lumunoz12/preprosthetic-robotic-hand/data/Test_Hand.xlsx

Sheet: Objects
ID | Grasp | Object | Mass (g) | Dimensions (mm) | Stiffness
PIN-1 | Pinch | Phone box | 16 | 80x67x19 | D
PIN-2 | Pinch | PCB | 10 | 72x44x1,6 | R
PIN-3 | Pinch | USB drive | 18 | 60x15,6x9 | R
LAT-1 | Lateral pinch | Phone charger | 27 | 48x35x14 | D
LAT-2 | Lateral pinch | PCB | 10 | 72x44x1,6 | R
LAT-3 | Lateral pinch | Phone box | 16 | 80x67x19 | D
CIL-1 | Cylindrical | Deodorant container | 61 | 25x141 | R
CIL-2 | Cylindrical | Plastic bottle | 122 | 38x227 | R
CIL-3 | Cylindrical | Aluminum bottle | 132 | 36,5x250 | R

Sheet: Test_Lateral
Intento | Objeto | Éxito (1)/Fracaso(0) | FSR indice max (ADC) | FSR pulgar max (ADC) | Ang. final MCP indice (°) | Ang. final PIP indice (°) | Ang. final ABD pulgar (°) | Ang. final MCP pulgar (°)
1 | LAT-1 | 1 | - | 38 | 73.8 | 44.5 | 17.2 | 64.2
2 | LAT-1 | 1 | - | 76 | 73.8 | 44.6 | 17.1 | 64.1
3 | LAT-1 | 1 | - | 45 | 74 | 44.7 | 17.2 | 64.5
4 | LAT-1 | 1 | - | 308 | 73.9 | 44.6 | 17.3 | 65.6
5 | LAT-1 | 1 | - | 122 | 74 | 47.4 | 20.6 | 64.8
1 | LAT-2 | 1 | - | 48 | 73.8 | 44.6 | 17.3 | 68.5
2 | LAT-2 | 1 | - | 37 | 73.8 | 47.4 | 20.5 | 67.7
3 | LAT-2 | 1 | - | 36 | 73.7 | 44.5 | 16.9 | 68.3
4 | LAT-2 | 1 | - | 37 | 74.2 | 46.1 | 20.4 | 68.3
5 | LAT-2 | 1 | - | 40 | 73.9 | 44.7 | 17.2 | 67.8
1 | LAT-3 | 1 | - | 41 | 74 | 47.5 | 20.8 | 63.9
2 | LAT-3 | 1 | - | 39 | 73.9 | 44.6 | 17.1 | 64
3 | LAT-3 | 1 | - | 41 | 74.5 | 46.6 | 20.4 | 64.2
4 | LAT-3 | 1 | - | 479 | 73.9 | 44.7 | 17.3 | 63.9
5 | LAT-3 | 1 | - | 347 | 73.7 | 44.4 | 17.3 | 63.9

Sheet: Test_Pinch
Intento | Objeto | Éxito (1)/Fracaso(0) | FSR indice max (ADC) | FSR pulgar max (ADC) | Ang. final MCP indice (°) | Ang. final PIP indice (°) | Ang. final ABD pulgar (°) | Ang. final MCP pulgar (°) | Observaciones
1 | PIN-1 | 1 | 58 | 47 | 81.2 | 68.6 | 71.6 | 53.6
2 | PIN-1 | 1 | 138 | 47 | 80.7 | 68.7 | 71.6 | 53.6
3 | PIN-1 | 1 | 298 | 43 | 86.4 | 68.8 | 72.1 | 53.7
4 | PIN-1 | 1 | 623 | 50 | 79.6 | 68.8 | 71 | 53.8
5 | PIN-1 | 1 | 227 | 52 | 86.9 | 65.5 | 70 | 53.8
1 | PIN-2 | 1 | 54 | 45 | 83.8 | 58 | 69.9 | 53.8
2 | PIN-2 | 0 | 0 | 0 | 83.8 | 62.5 | 69.9 | 53.7
3 | PIN-2 | 0 | 0 | 0 | 84 | 62.8 | 69.9 | 53.8
4 | PIN-2 | 0 | 0 | 0 | 84.1 | 62.7 | 69.9 | 52.8
5 | PIN-2 | 0 | 0 | 0 | 84 | 63.2 | 69.8 | 53.7
1 | PIN-3 | 1 | 58 | 58 | 83.9 | 68.9 | 71.6 | 53.6
2 | PIN-3 | 0 | 0 | 0 | 83.7 | 62.6 | 69.9 | 53.7 | Error en PIP indice
3 | PIN-3 | 1 | 42 | 59 | 83.6 | 68.4 | 71.7 | 53.8
4 | PIN-3 | 1 | 48 | 54 | 83.6 | 68.6 | 72 | 53.7
5 | PIN-3 | 0 | 0 | 0 | 83.9 | 64.4 | 70.4 | 53.7

Sheet: Test_Cylindrical
Intento | Objeto | Éxito (1)/Fracaso(0) | FSR indice max (ADC) | FSR pulgar max (ADC) | Ang. final MCP indice (°) | Ang. final PIP indice (°) | Ang. final ABD pulgar (°) | Ang. final MCP pulgar (°) | Ang. final MCP medio (°) | Ang. final PIP medio (°) | Ang. final MCP anular (°) | Ang. final PIP anular (°) | Ang. final MCP meñique (°) | Ang. final PIP meñique (°)
1 | CIL-1 | 0 | 30 | 38 | 71.7 | 69.6 | 78.7 | 58.7 | 73.5 | 69.1 | 74.6 | 69.6 | 73.5 | 68.7
2 | CIL-1 | 0 | 35 | 36 | 72.8 | 70 | 78.5 | 58.4 | 77.6 | 69.2 | 78.2 | 73.6 | 77.6 | 68.7
3 | CIL-1 | 0 | 40 | 37 | 73.9 | 69.8 | 78.7 | 58.6 | 78.2 | 69.3 | 78.7 | 72.6 | 78.1 | 68.7
4 | CIL-1 | 0 | 38 | 35 | 71.9 | 69.4 | 78.7 | 58.5 | 73.3 | 68.9 | 74.2 | 69.8 | 73.4 | 68.8
5 | CIL-1 | 0 | 37 | 39 | 73.5 | 69.8 | 78.6 | 58.6 | 77.2 | 69.2 | 77.8 | 73 | 77.2 | 68.8
1 | CIL-2 | 1 | 30 | 30 | 62.5 | 55.1 | 78.4 | 43.5 | 63.7 | 54 | 64.9 | 55.2 | 63.9 | 54.3
2 | CIL-2 | 1 | 35 | 36 | 62.5 | 55.2 | 78.4 | 43.6 | 63.9 | 54.4 | 65 | 55.2 | 64 | 54.4
3 | CIL-2 | 0 | 38 | 43 | 62.6 | 54.9 | 78.5 | 43.6 | 63.7 | 54.5 | 65.2 | 0 | 63.6 | 54.2
4 | CIL-2 | 0 | 33 | 34 | 62.6 | 55.1 | 78.7 | 43.5 | 68 | 54.2 | 67.5 | 57.7 | 68 | 54.7
5 | CIL-2 | 1 | 37 | 37 | 64.3 | 56.4 | 78.7 | 43.6 | 68 | 55.3 | 68.6 | 58.1 | 68 | 56.2
1 | CIL-3 | 0 | 40 | 44 | 65.5 | 60.9 | 78.8 | 48.6 | 69.5 | 59.3 | 68.6 | 63.9 | 69.5 | 60.3
2 | CIL-3 | 0 | 43 | 39 | 62.6 | 60.2 | 78.7 | 48.6 | 64.6 | 59.2 | 66.4 | 59.5 | 65.1 | 59
3 | CIL-3 | 0 | 33 | 38 | 63.3 | 59.7 | 78.6 | 48.6 | 64.6 | 59.3 | 66.5 | 59.4 | 65.2 | 58.9
4 | CIL-3 | 0 | 30 | 33 | 65 | 61 | 78.6 | 48.6 | 68.9 | 59.3 | 69.7 | 62.3 | 69 | 59.6
5 | CIL-3 | 0 | 39 | 51 | 62.4 | 61.2 | 78.6 | 48.7 | 68.6 | 59.3 | 69.1 | 63.6 | 68.7 | 59.6

Sheet: Stats
Statistics per object (n = 5 attempts, including failures). Mean and sample standard deviation (STDEV). Paper Tables IV and V.
Object | Successes | Index FSR mean (ADC) | Index FSR SD (ADC) | Thumb FSR mean (ADC) | Thumb FSR SD (ADC) | Index MCP mean (°) | Index MCP SD (°) | Index PIP mean (°) | Index PIP SD (°) | Thumb ABD mean (°) | Thumb ABD SD (°) | Thumb MCP mean (°) | Thumb MCP SD (°)
PIN-1 | 5 | 268.8 | 217.7 | 47.8 | 3.4 | 83.0 | 3.4 | 68.1 | 1.4 | 71.3 | 0.8 | 53.7 | 0.1
PIN-2 | 1 | 10.8 | 24.1 | 9.0 | 20.1 | 83.9 | 0.1 | 61.8 | 2.2 | 69.9 | 0.04472135955 | 53.6 | 0.4
PIN-3 | 3 | 29.6 | 27.6 | 34.2 | 31.3 | 83.7 | 0.2 | 66.6 | 2.9 | 71.1 | 0.9 | 53.7 | 0.1
Pinch total | 9
LAT-1 | 5 | – | – | 117.8 | 111.4 | 73.9 | 0.1 | 45.2 | 1.3 | 17.9 | 1.5 | 64.6 | 0.6
LAT-2 | 5 | – | – | 39.6 | 4.9 | 73.9 | 0.2 | 45.5 | 1.3 | 18.5 | 1.8 | 68.1 | 0.3
LAT-3 | 5 | – | – | 189.4 | 209.4 | 74.0 | 0.3 | 45.6 | 1.4 | 18.6 | 1.9 | 64.0 | 0.1
Lateral total | 15
CIL-1 | 0 | 36.0 | 3.8 | 37.0 | 1.6 | 72.8 | 1.0 | 69.7 | 0.2 | 78.6 | 0.1 | 58.6 | 0.1
CIL-2 | 3 | 34.6 | 3.2 | 36.0 | 4.7 | 62.9 | 0.8 | 55.3 | 0.6 | 78.5 | 0.2 | 43.6 | 0.1
CIL-3 | 0 | 37.0 | 5.3 | 41.0 | 6.8 | 63.8 | 1.4 | 60.6 | 0.6 | 78.7 | 0.1 | 48.6 | 0.04472135955
Cylindrical total | 3
Successes are out of 5 attempts per object (15 per grasp pattern). Index FSR values were not recorded for lateral pinch.
