lumunoz12/preprosthetic-robotic-hand/cad/stl/mano_final_V3_transmision_motor_medio_84.stl

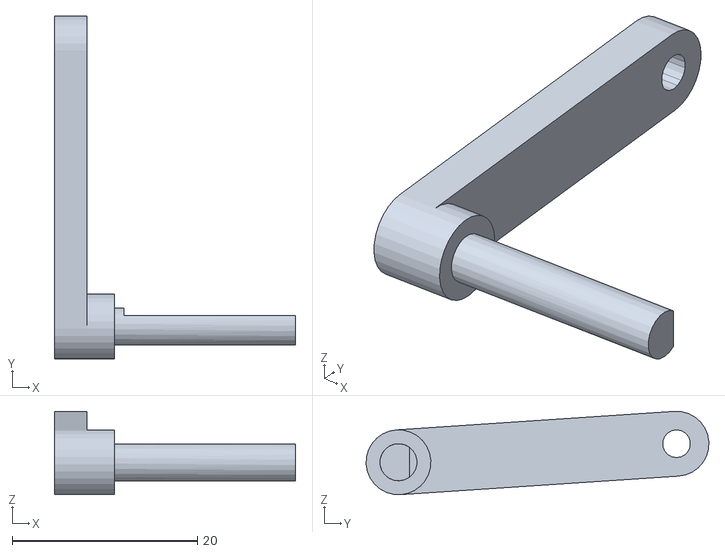
[picture p2: CAD file, 2026-10-22]
cad/stl/mano_final_V3_transmision_motor_medio_84.stl
26.0 x 37.0 x 8.98
