lumunoz12/preprosthetic-robotic-hand/matlab/simulink/cad/Tierra_Indice_ipt_749dbfaf.STEP

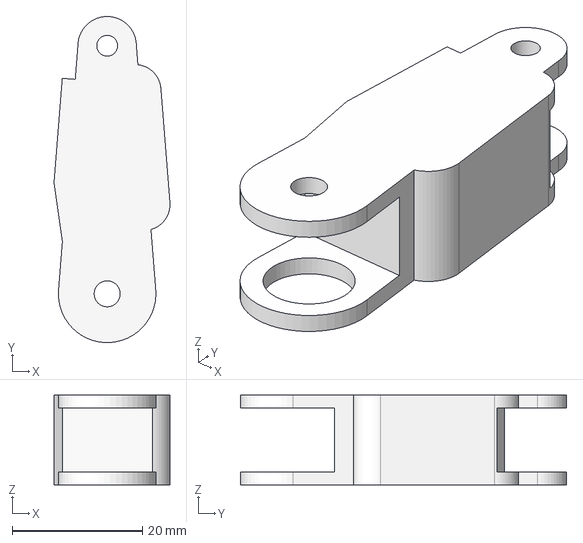
[picture p3: CAD file, 2026-10-24]
matlab/simulink/cad/Tierra_Indice_ipt_749dbfaf.STEP
17.8 x 50.1 x 13.8 mm
