lumunoz12/preprosthetic-robotic-hand/cad/stl/mano_final_V3_Tapa_meta_indice_35.stl

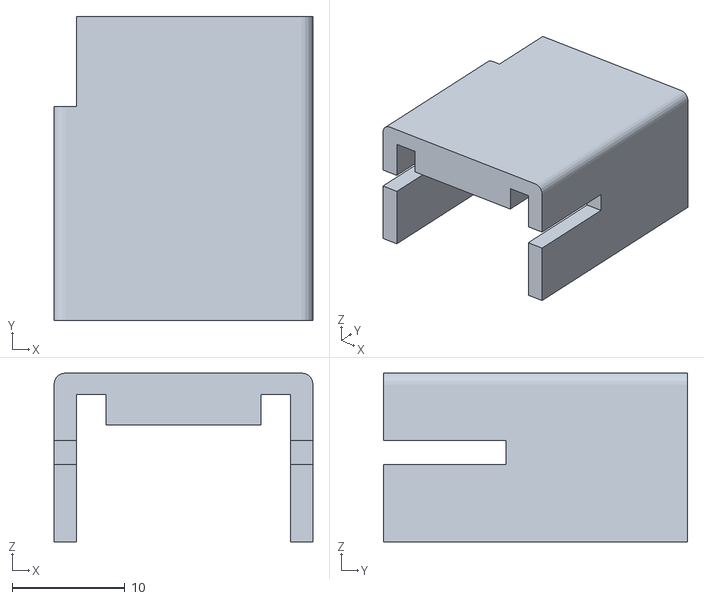
[picture p4: CAD file, 2026-10-22]
cad/stl/mano_final_V3_Tapa_meta_indice_35.stl
23.0 x 27.0 x 15.0
