lumunoz12/preprosthetic-robotic-hand/matlab/simulink/cad/Prox_Indice_ipt_552c8f7.STEP

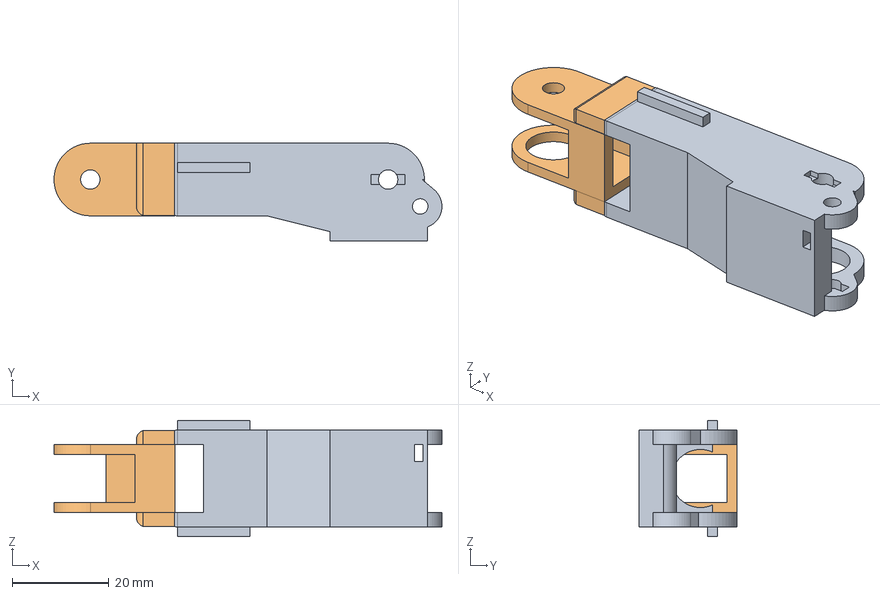
[picture p5: CAD file, 2026-10-24]
matlab/simulink/cad/Prox_Indice_ipt_552c8f7.STEP
80.1 x 20.1 x 24.0 mm
