lumunoz12/preprosthetic-robotic-hand/cad/stl/mano_final_V3_transmision_motor_82.stl

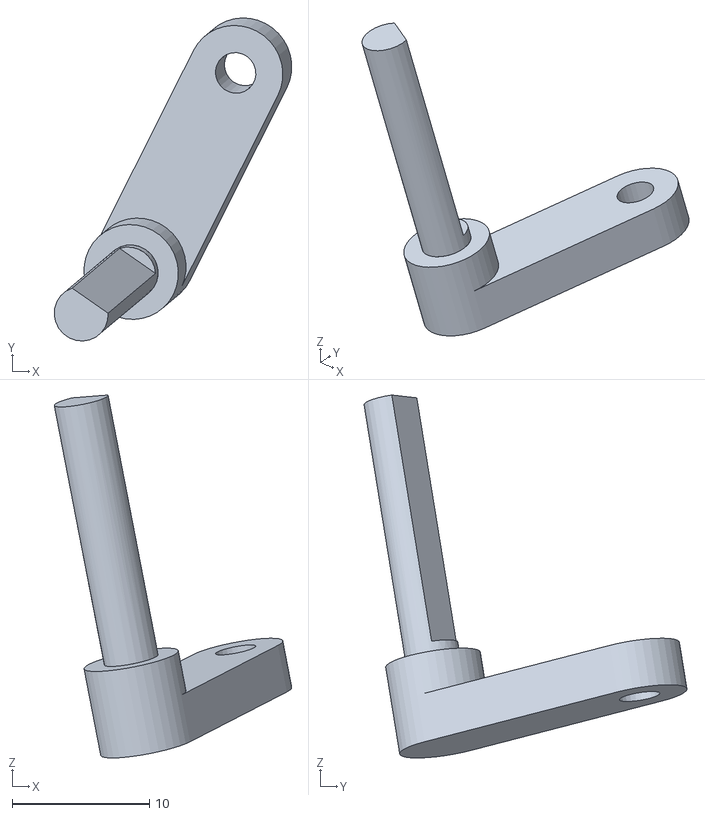
[picture p6: CAD file, 2026-10-22]
cad/stl/mano_final_V3_transmision_motor_82.stl
17.3 x 23.5 x 26.5
