lumunoz12/preprosthetic-robotic-hand/matlab/simulink/cad/Tapa_prox_medio_ipt_ad682b4a.STEP

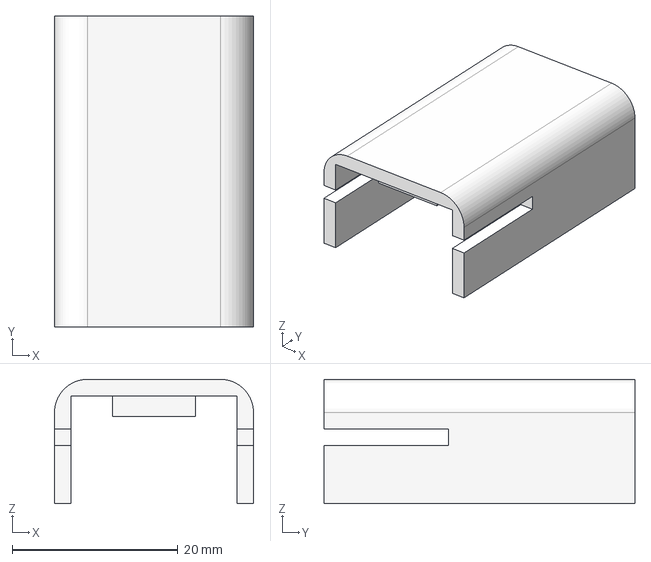
[picture p7: CAD file, 2026-10-24]
matlab/simulink/cad/Tapa_prox_medio_ipt_ad682b4a.STEP
24.0 x 37.5 x 15.0 mm
