lumunoz12/preprosthetic-robotic-hand/cad/stl/mano_final_V3_Meta_anular_15.stl

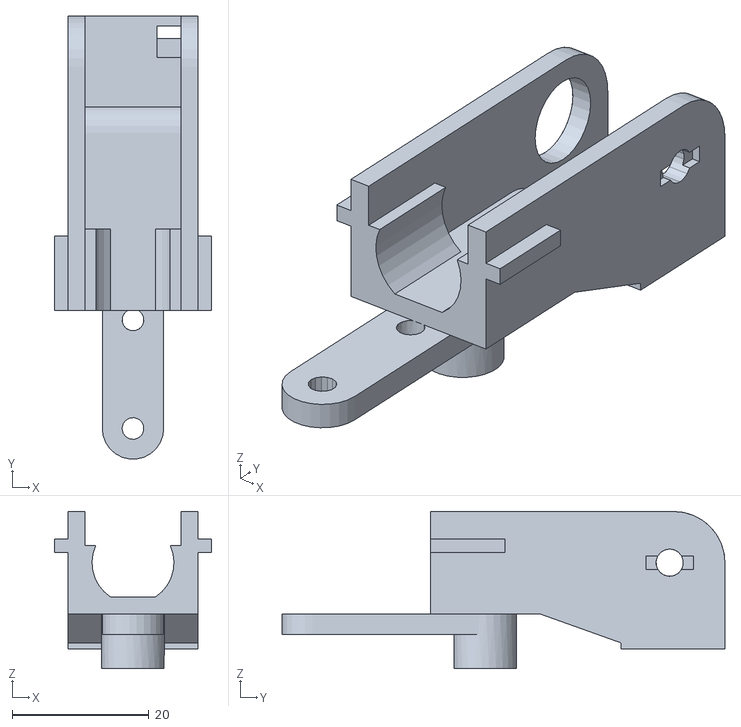
[picture p8: CAD file, 2026-10-22]
cad/stl/mano_final_V3_Meta_anular_15.stl
23.0 x 64.9 x 23.0
