lumunoz12/preprosthetic-robotic-hand/matlab/simulink/cad/Esl4_ipt_c84328c3.STEP

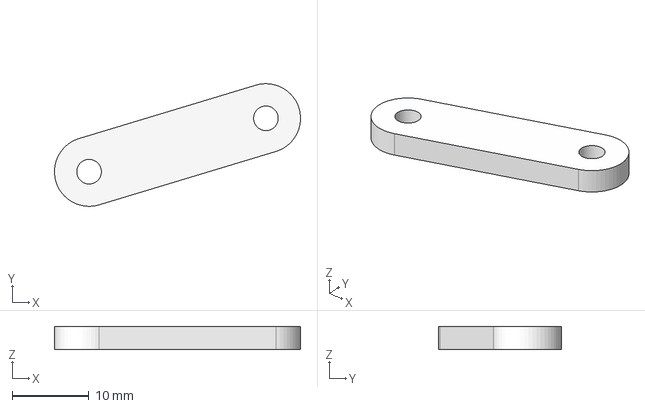
[picture p9: CAD file, 2026-10-24]
matlab/simulink/cad/Esl4_ipt_c84328c3.STEP
32.0 x 15.9 x 3.00 mm
