lumunoz12/preprosthetic-robotic-hand/cad/stl/mano_final_V3_Diag_pulgar_4.stl

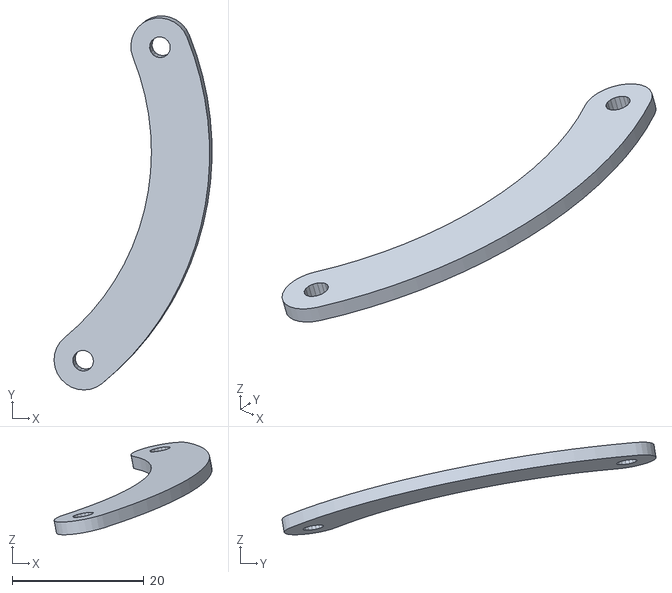
[picture p10: CAD file, 2026-10-22]
cad/stl/mano_final_V3_Diag_pulgar_4.stl
24.0 x 56.8 x 14.1
