lumunoz12/preprosthetic-robotic-hand/matlab/simulink/cad/segunda_anular2_ipt_baa67ac8.STEP

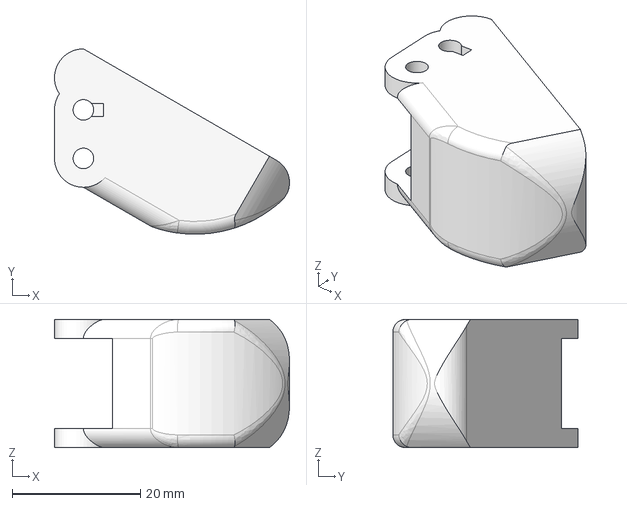
[picture p11: CAD file, 2026-10-24]
matlab/simulink/cad/segunda_anular2_ipt_baa67ac8.STEP
36.6 x 28.9 x 20.0 mm
