lumunoz12/preprosthetic-robotic-hand/cad/stl/mano_final_V3_Tierra_Indice_19.stl

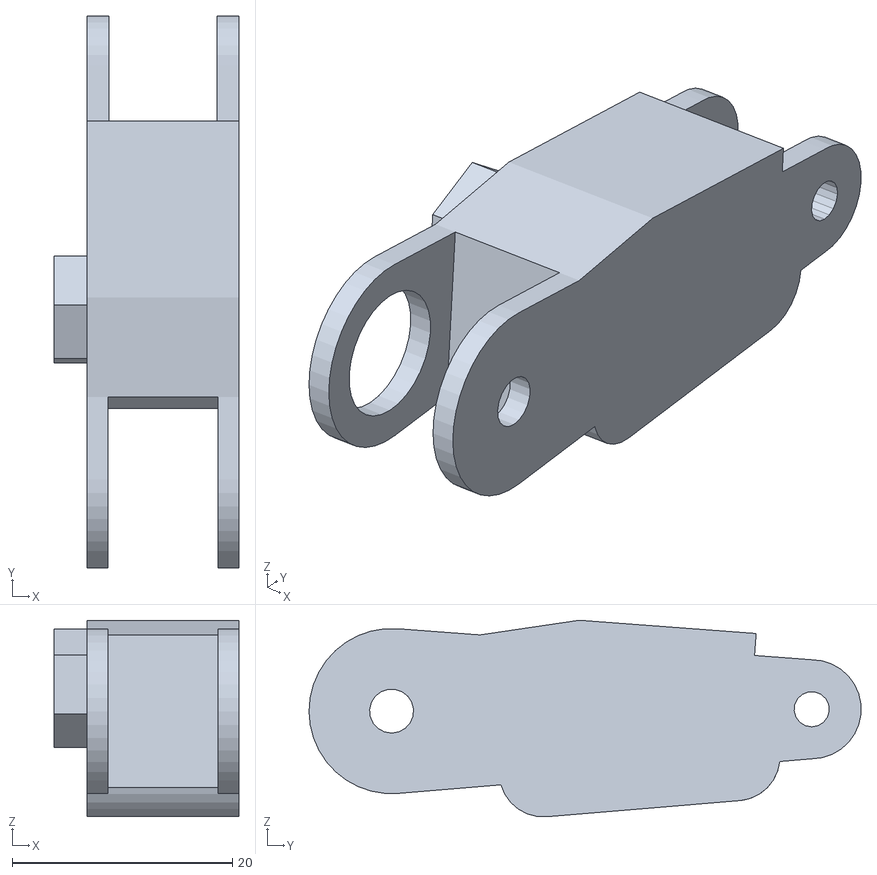
[picture p12: CAD file, 2026-10-22]
cad/stl/mano_final_V3_Tierra_Indice_19.stl
16.8 x 50.1 x 17.8
