lumunoz12/preprosthetic-robotic-hand/matlab/simulink/cad/Cubre_palma_ipt_2d8e42c4.STEP

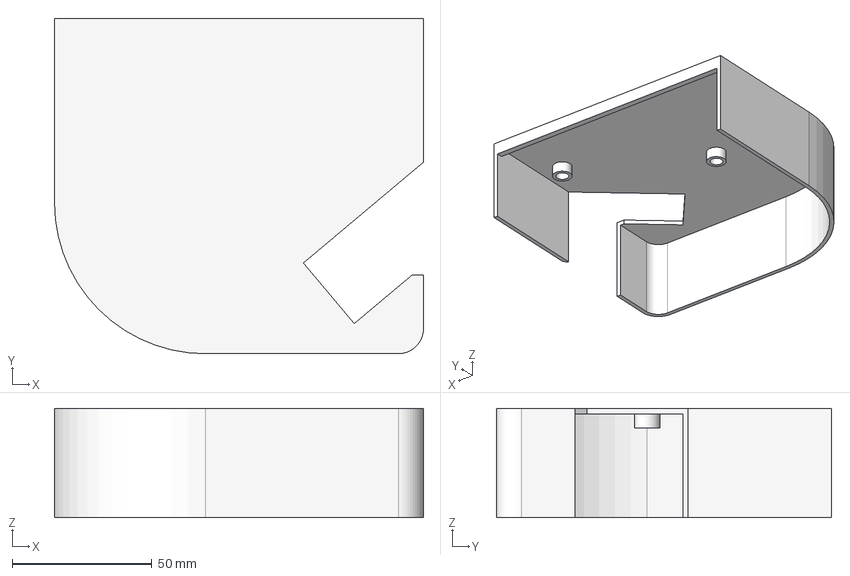
[picture p13: CAD file, 2026-10-24]
matlab/simulink/cad/Cubre_palma_ipt_2d8e42c4.STEP
132.0 x 120.0 x 39.0 mm
