lumunoz12/preprosthetic-robotic-hand/cad/stl/mano_final_V3_Tierra_pulgar_3.stl

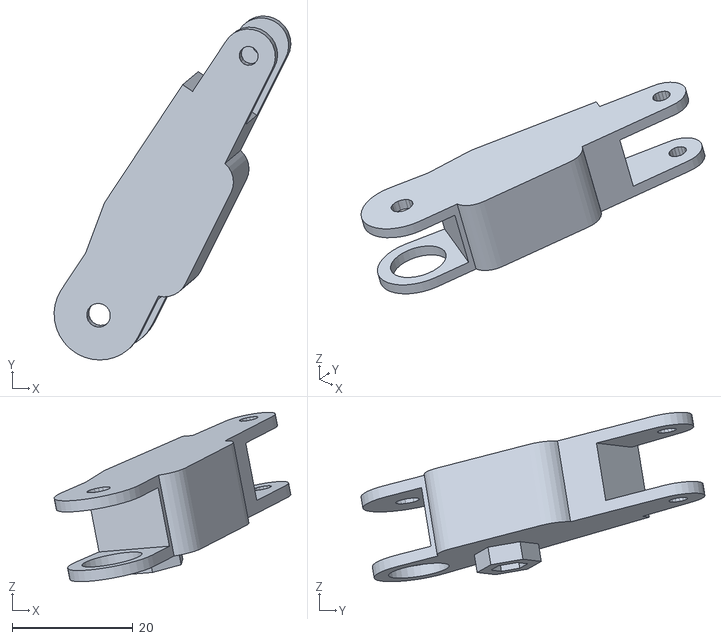
[picture p14: CAD file, 2026-10-22]
cad/stl/mano_final_V3_Tierra_pulgar_3.stl
39.2 x 57.0 x 28.0
