lumunoz12/preprosthetic-robotic-hand/matlab/simulink/cad/Meta_menique_ipt_b8010d53.STEP

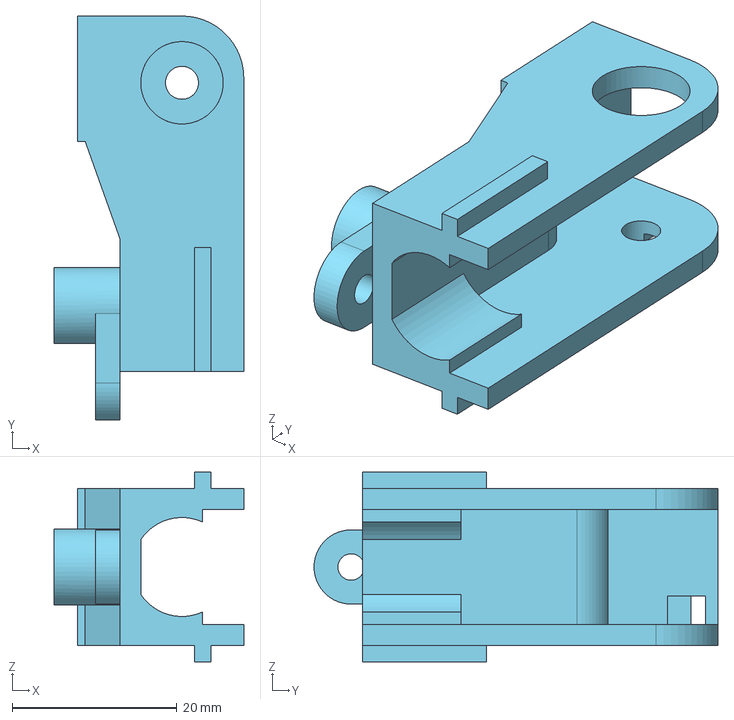
[picture p15: CAD file, 2026-10-24]
matlab/simulink/cad/Meta_menique_ipt_b8010d53.STEP
23.0 x 49.0 x 23.0 mm
