lumunoz12/preprosthetic-robotic-hand/matlab/simulink/cad/Diag_menique_ipt_fb0efa85.STEP

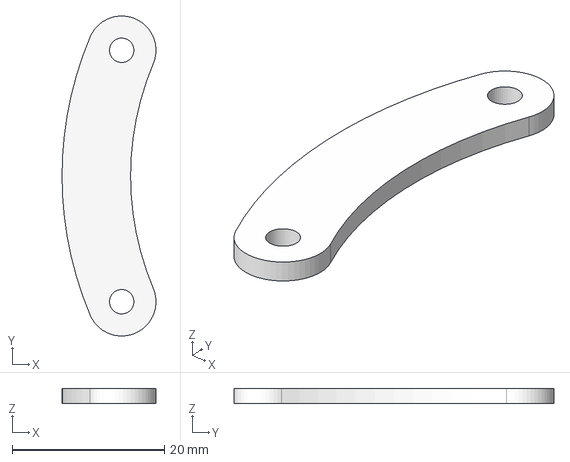
[picture p16: CAD file, 2026-10-24]
matlab/simulink/cad/Diag_menique_ipt_fb0efa85.STEP
12.3 x 42.0 x 2.00 mm
