lumunoz12/preprosthetic-robotic-hand/cad/stl/mano_final_V3_transmision_motor_80.stl

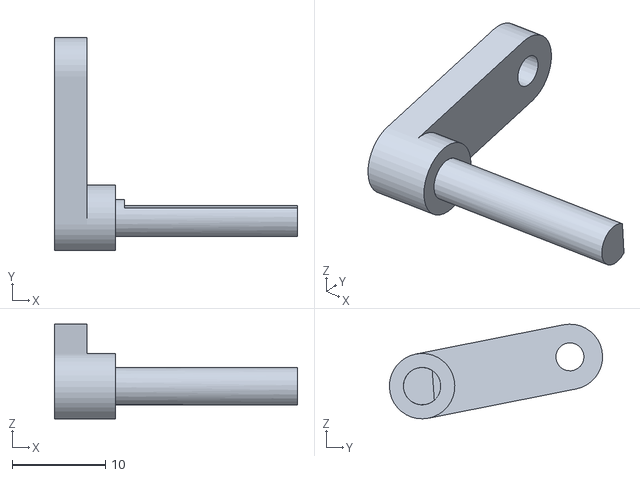
[picture p17: CAD file, 2026-10-22]
cad/stl/mano_final_V3_transmision_motor_80.stl
26.0 x 22.8 x 10.1
