lumunoz12/preprosthetic-robotic-hand/cad/stl/mano_final_V3_Tapa_prox_medio_38.stl

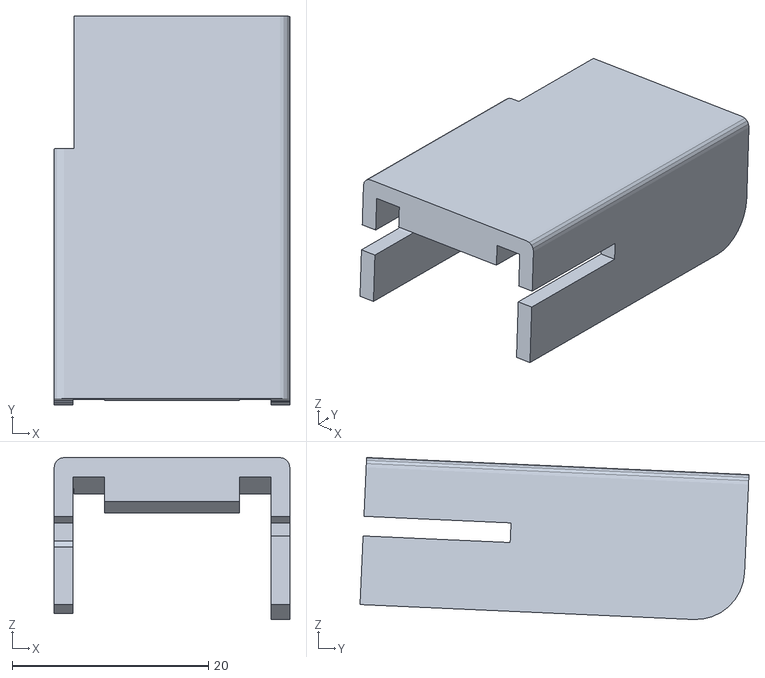
[picture p19: CAD file, 2026-10-22]
cad/stl/mano_final_V3_Tapa_prox_medio_38.stl
24.0 x 39.6 x 16.5
