lumunoz12/preprosthetic-robotic-hand/matlab/simulink/cad/Diag_Anular_ipt_fb0efa85.STEP

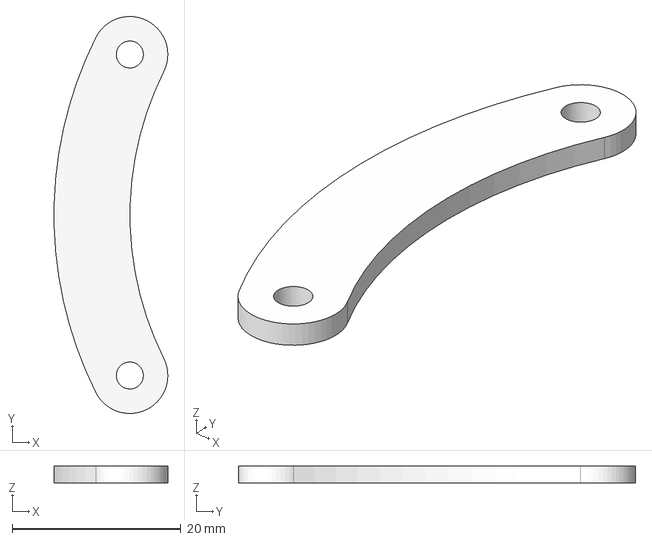
[picture p20: CAD file, 2026-10-24]
matlab/simulink/cad/Diag_Anular_ipt_fb0efa85.STEP
13.5 x 47.0 x 2.00 mm
