lumunoz12/preprosthetic-robotic-hand/cad/stl/mano_final_V3_Tierra_menique_10.stl

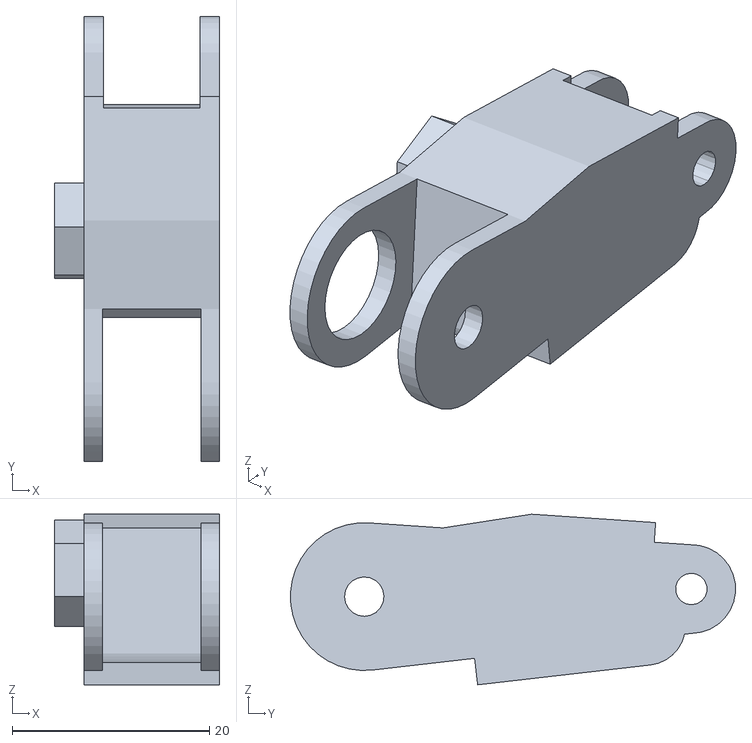
[picture p21: CAD file, 2026-10-22]
cad/stl/mano_final_V3_Tierra_menique_10.stl
16.8 x 45.2 x 17.3
