lumunoz12/preprosthetic-robotic-hand/matlab/simulink/cad/Prox_menique_ipt_552c8f7.STEP

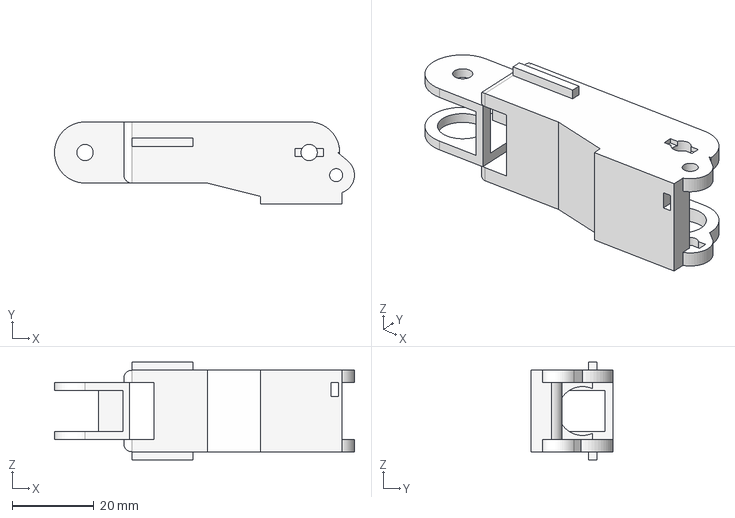
[picture p22: CAD file, 2026-10-24]
matlab/simulink/cad/Prox_menique_ipt_552c8f7.STEP
73.6 x 20.1 x 24.0 mm
