lumunoz12/preprosthetic-robotic-hand/cad/stl/mano_final_V3_Diag_menique_13.stl

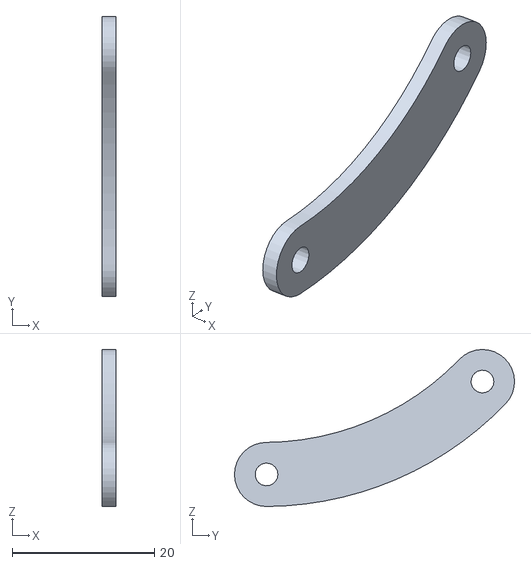
[picture p23: CAD file, 2026-10-22]
cad/stl/mano_final_V3_Diag_menique_13.stl
2.00 x 39.3 x 22.0
