lumunoz12/preprosthetic-robotic-hand/matlab/simulink/cad/Prox_anularVF2_ipt_566e7249.STEP

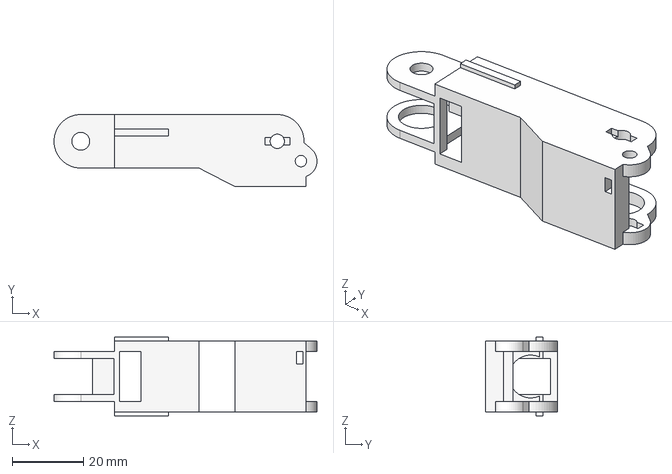
[picture p24: CAD file, 2026-10-24]
matlab/simulink/cad/Prox_anularVF2_ipt_566e7249.STEP
73.6 x 20.2 x 22.0 mm
