lumunoz12/preprosthetic-robotic-hand/cad/stl/mano_final_V3_Prox_anularVF2_36.stl

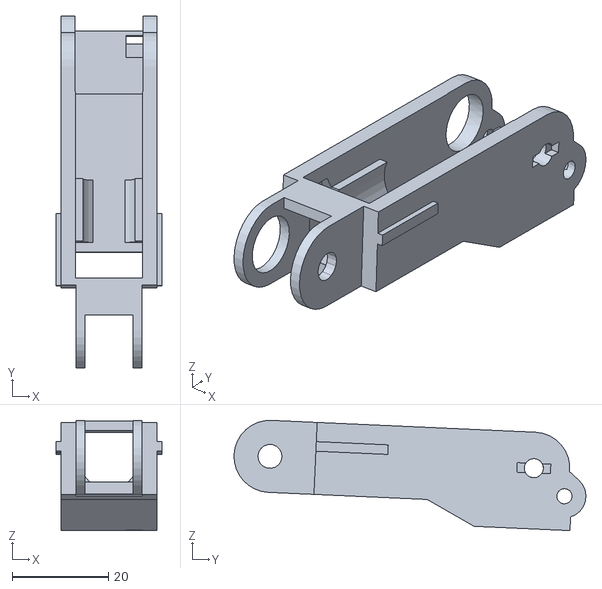
[picture p25: CAD file, 2026-10-22]
cad/stl/mano_final_V3_Prox_anularVF2_36.stl
22.0 x 73.3 x 23.0
