lumunoz12/preprosthetic-robotic-hand/matlab/simulink/cad/Prox_medio_ipt_552c8f7.STEP

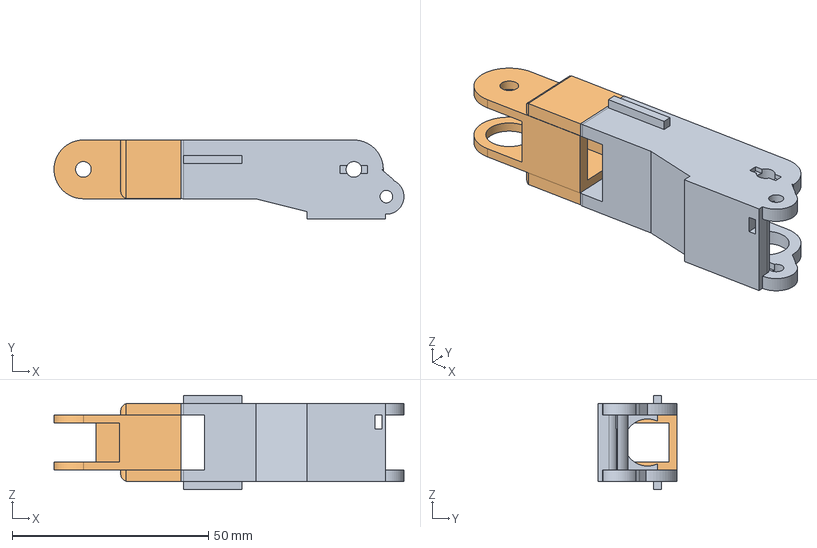
[picture p26: CAD file, 2026-10-24]
matlab/simulink/cad/Prox_medio_ipt_552c8f7.STEP
89.3 x 20.1 x 24.0 mm
