lumunoz12/preprosthetic-robotic-hand/cad/stl/mano_final_V3_Prox_menique_9.stl

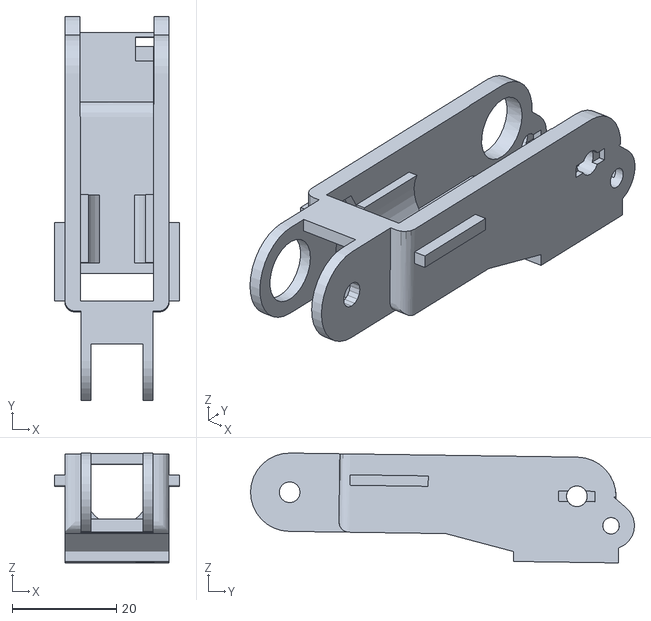
[picture p27: CAD file, 2026-10-22]
cad/stl/mano_final_V3_Prox_menique_9.stl
24.0 x 73.5 x 21.0
