lumunoz12/preprosthetic-robotic-hand/matlab/simulink/cad/Meta_indice_ipt_b8010d53.STEP

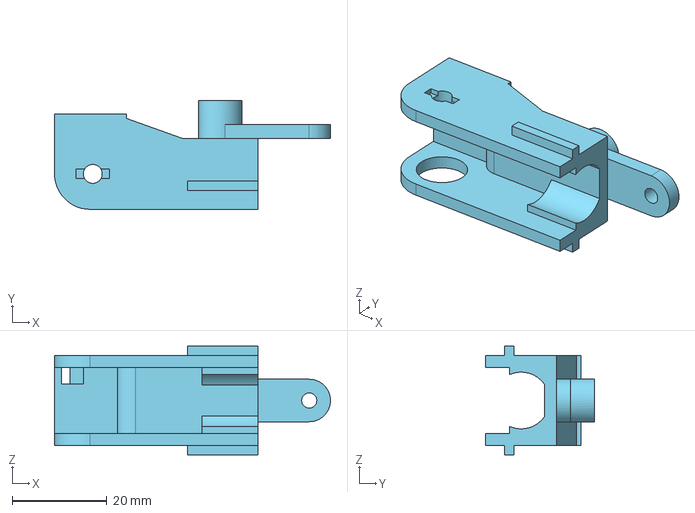
[picture p28: CAD file, 2026-10-24]
matlab/simulink/cad/Meta_indice_ipt_b8010d53.STEP
58.4 x 23.0 x 23.0 mm
