lumunoz12/preprosthetic-robotic-hand/cad/stl/mano_final_V3_distal_menique_12.stl

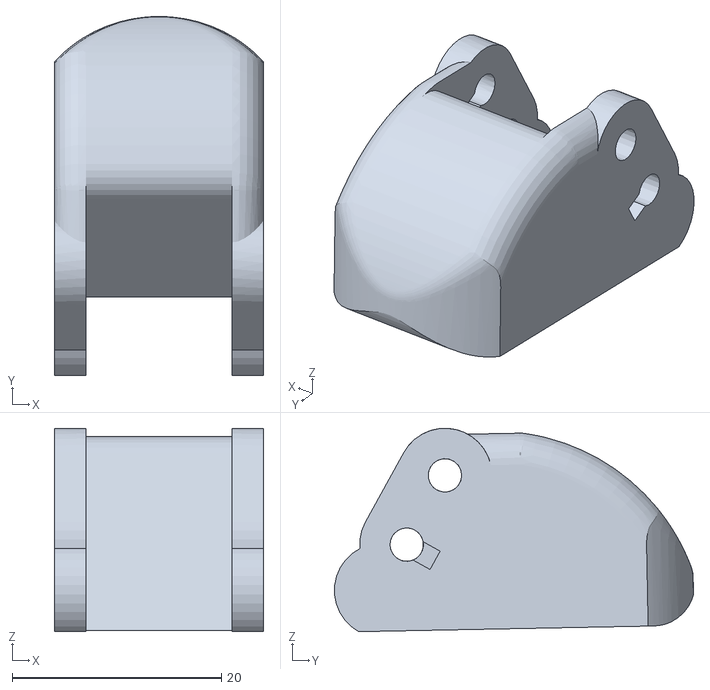
[picture p29: CAD file, 2026-10-22]
cad/stl/mano_final_V3_distal_menique_12.stl
20.0 x 34.3 x 19.4
