lumunoz12/preprosthetic-robotic-hand/matlab/simulink/cad/distal_menique_ipt_baa67ac8.STEP

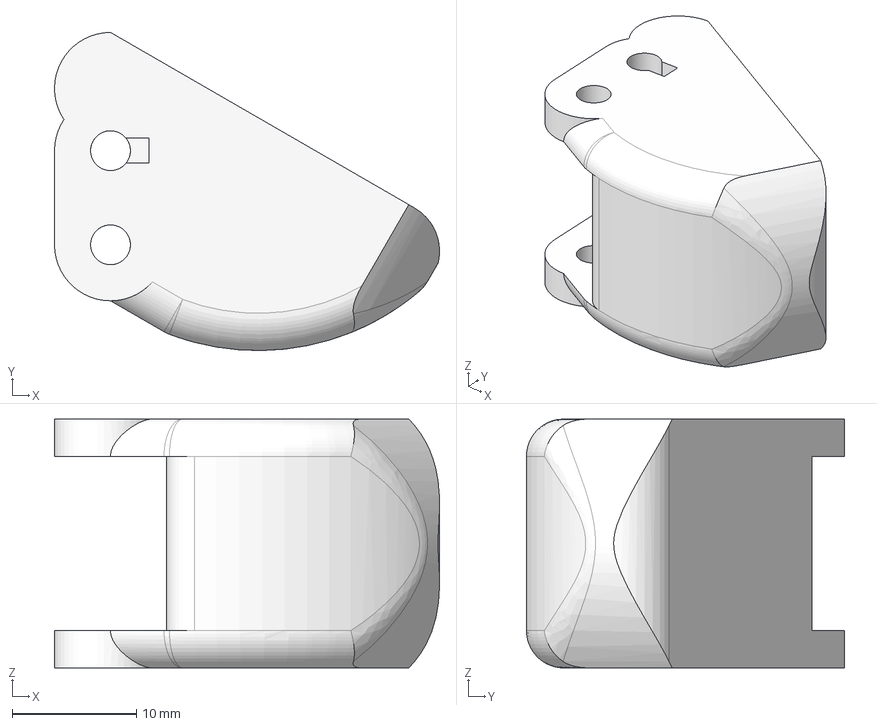
[picture p30: CAD file, 2026-10-24]
matlab/simulink/cad/distal_menique_ipt_baa67ac8.STEP
30.9 x 25.6 x 20.0 mm
