lumunoz12/preprosthetic-robotic-hand/cad/stl/mano_final_V3_Tierra_medio_25.stl

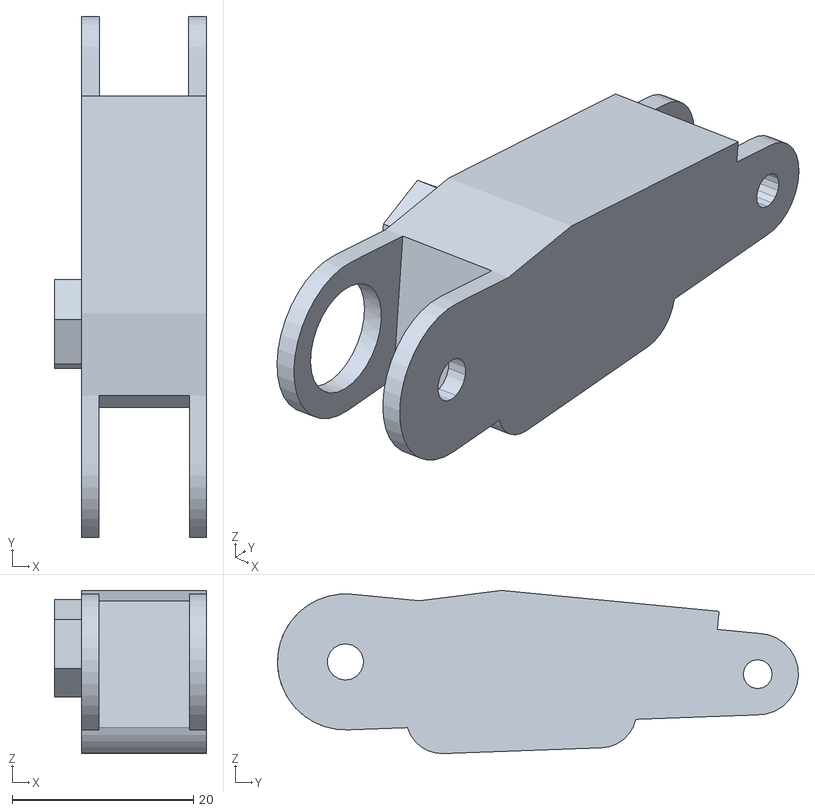
[picture p31: CAD file, 2026-10-22]
cad/stl/mano_final_V3_Tierra_medio_25.stl
16.8 x 57.5 x 18.0
