lumunoz12/preprosthetic-robotic-hand/matlab/simulink/cad/Diag_medio_ipt_fb0efa85.STEP

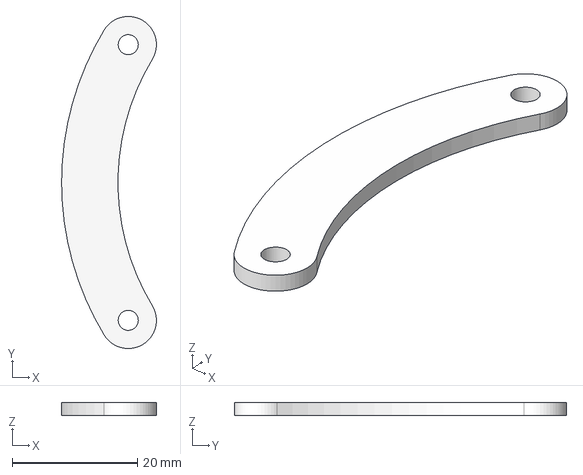
[picture p32: CAD file, 2026-10-24]
matlab/simulink/cad/Diag_medio_ipt_fb0efa85.STEP
15.1 x 53.0 x 2.00 mm
