lumunoz12/preprosthetic-robotic-hand/cad/stl/mano_final_V3_Tapa_prox_medio_29.stl

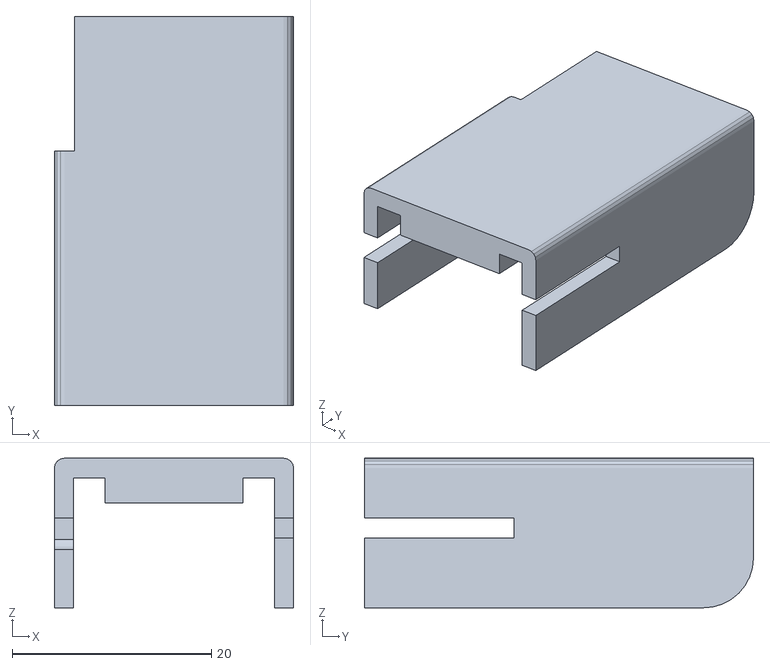
[picture p33: CAD file, 2026-10-22]
cad/stl/mano_final_V3_Tapa_prox_medio_29.stl
24.0 x 39.0 x 15.0
