lumunoz12/preprosthetic-robotic-hand/matlab/simulink/cad/Tapa_meta_indice_ipt_ad682b4a.STEP

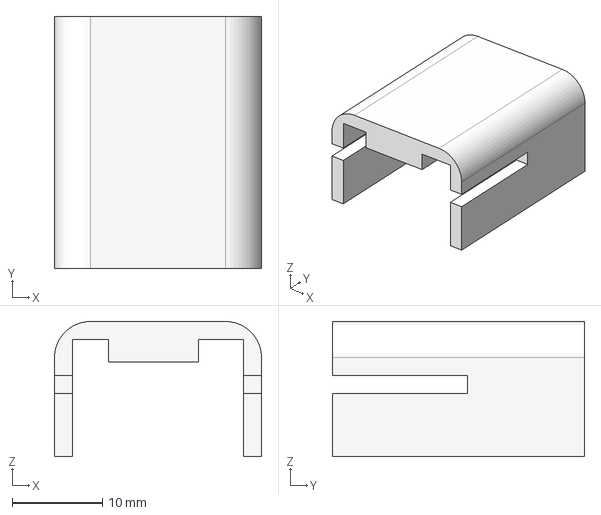
[picture p34: CAD file, 2026-10-24]
matlab/simulink/cad/Tapa_meta_indice_ipt_ad682b4a.STEP
23.0 x 28.0 x 15.0 mm
