lumunoz12/preprosthetic-robotic-hand/cad/stl/mano_final_V3_Meta_menique_8.stl

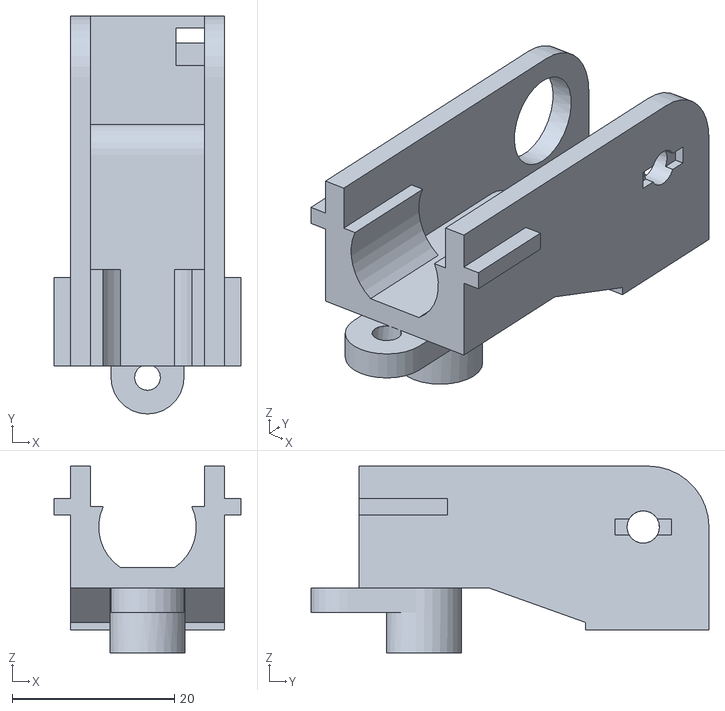
[picture p35: CAD file, 2026-10-22]
cad/stl/mano_final_V3_Meta_menique_8.stl
23.0 x 49.0 x 23.0
