lumunoz12/preprosthetic-robotic-hand/matlab/simulink/cad/Esl3_ipt_c845c934.STEP

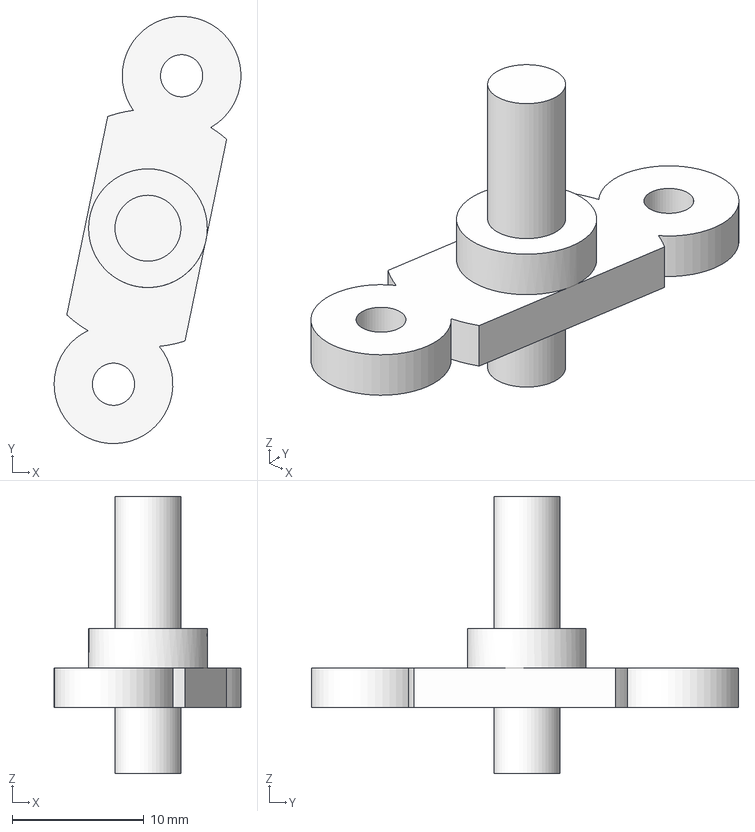
[picture p36: CAD file, 2026-10-24]
matlab/simulink/cad/Esl3_ipt_c845c934.STEP
14.2 x 32.4 x 21.0 mm
