lumunoz12/preprosthetic-robotic-hand/matlab/simulink/cad/Palma_ipt_e803cfc2.STEP

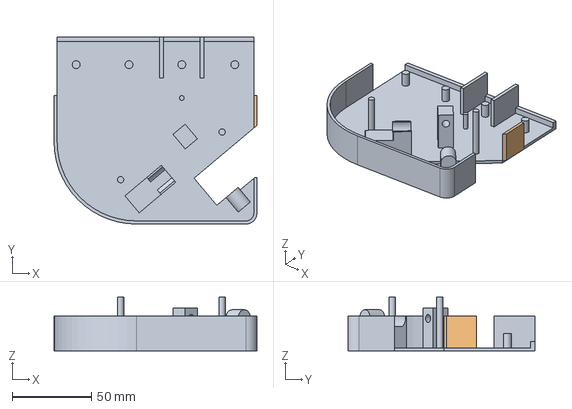
[picture p38: CAD file, 2026-10-24]
matlab/simulink/cad/Palma_ipt_e803cfc2.STEP
128.0 x 118.0 x 34.0 mm
