lumunoz12/preprosthetic-robotic-hand/matlab/simulink/cad/distal_indice_ipt_baa67ac8.STEP

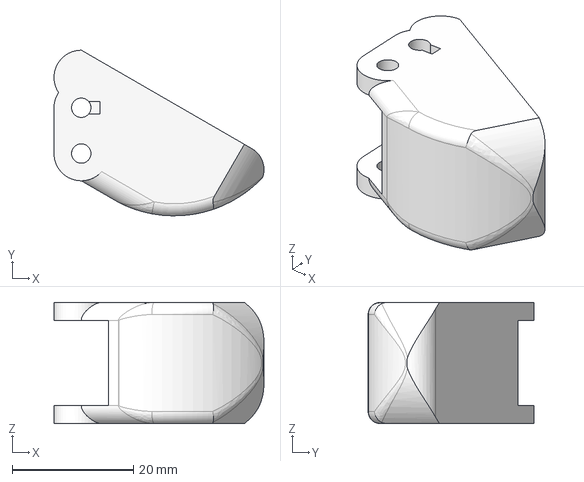
[picture p40: CAD file, 2026-10-24]
matlab/simulink/cad/distal_indice_ipt_baa67ac8.STEP
34.7 x 27.3 x 20.0 mm
