lumunoz12/preprosthetic-robotic-hand/cad/stl/mano_final_V3_transmision_motor_anular_85.stl

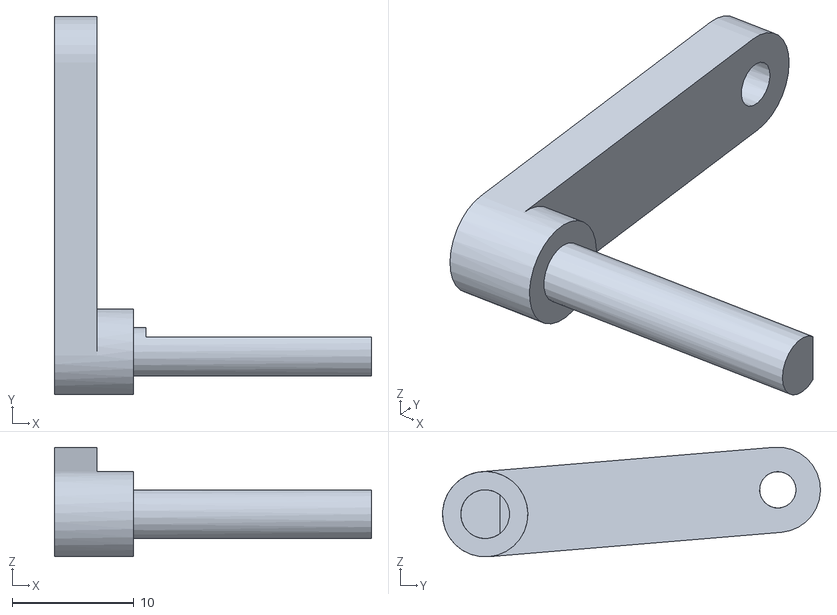
[picture p41: CAD file, 2026-10-22]
cad/stl/mano_final_V3_transmision_motor_anular_85.stl
26.0 x 31.0 x 8.98
