lumunoz12/preprosthetic-robotic-hand/matlab/simulink/cad/Diag_pulgar_ipt_fb0efa85.STEP

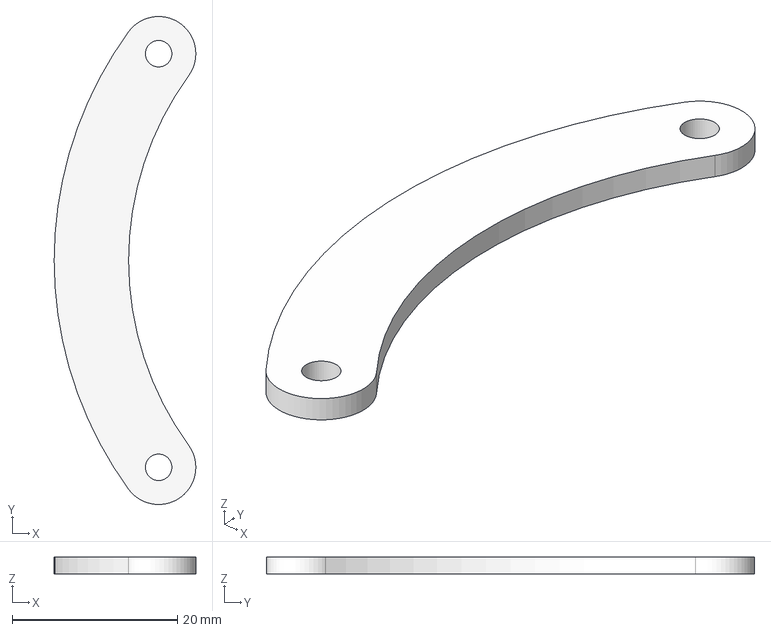
[picture p42: CAD file, 2026-10-24]
matlab/simulink/cad/Diag_pulgar_ipt_fb0efa85.STEP
17.1 x 59.0 x 2.00 mm
