lumunoz12/preprosthetic-robotic-hand/cad/stl/mano_final_V3_Diag_Indice_22.stl

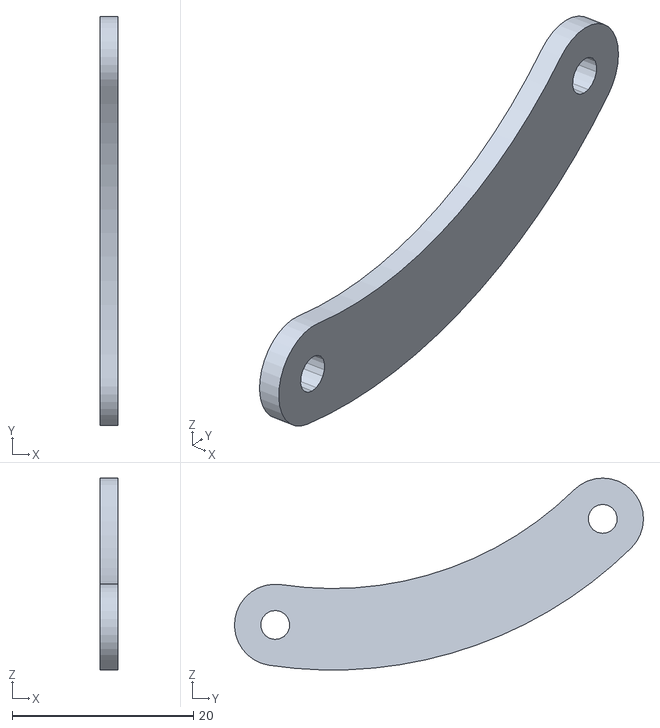
[picture p43: CAD file, 2026-10-22]
cad/stl/mano_final_V3_Diag_Indice_22.stl
2.00 x 45.1 x 21.2
