lumunoz12/preprosthetic-robotic-hand/matlab/simulink/cad/distal_medio_ipt_baa67ac8.STEP

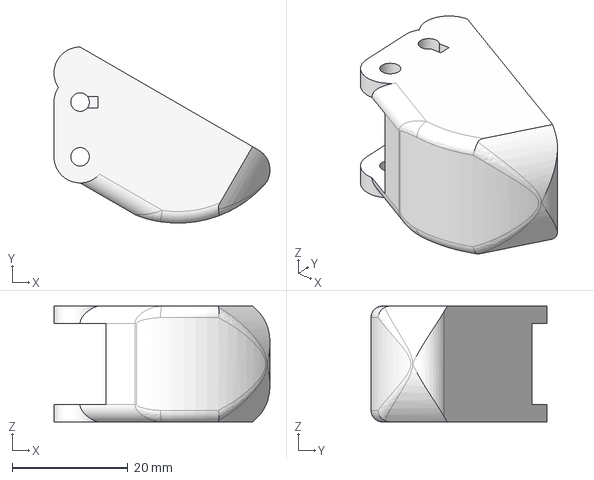
[picture p44: CAD file, 2026-10-24]
matlab/simulink/cad/distal_medio_ipt_baa67ac8.STEP
37.3 x 30.4 x 20.0 mm
