lumunoz12/preprosthetic-robotic-hand/cad/stl/mano_final_V3_transmision_motor_79.stl

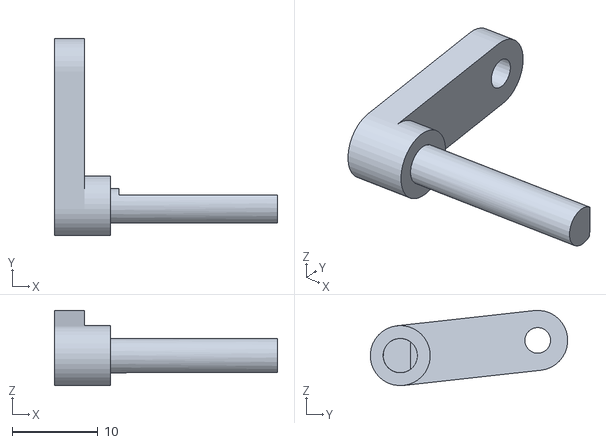
[picture p45: CAD file, 2026-10-22]
cad/stl/mano_final_V3_transmision_motor_79.stl
26.0 x 23.0 x 8.76
