lumunoz12/preprosthetic-robotic-hand/cad/stl/mano_final_V3_Cubre_palma_39.stl

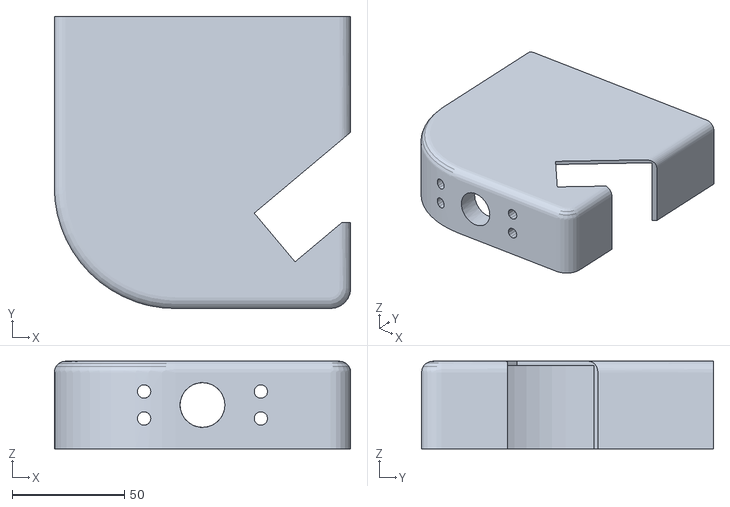
[picture p46: CAD file, 2026-10-22]
cad/stl/mano_final_V3_Cubre_palma_39.stl
132.0 x 130.0 x 39.0
