lumunoz12/preprosthetic-robotic-hand/matlab/simulink/cad/distal_pulgar_ipt_baa67ac8.STEP

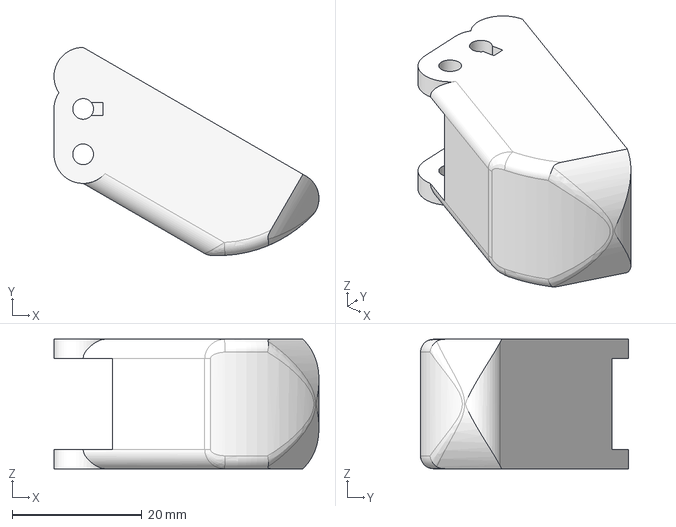
[picture p47: CAD file, 2026-10-24]
matlab/simulink/cad/distal_pulgar_ipt_baa67ac8.STEP
40.9 x 32.1 x 20.0 mm
