lumunoz12/preprosthetic-robotic-hand/cad/stl/mano_final_V3_Diag_medio_30.stl

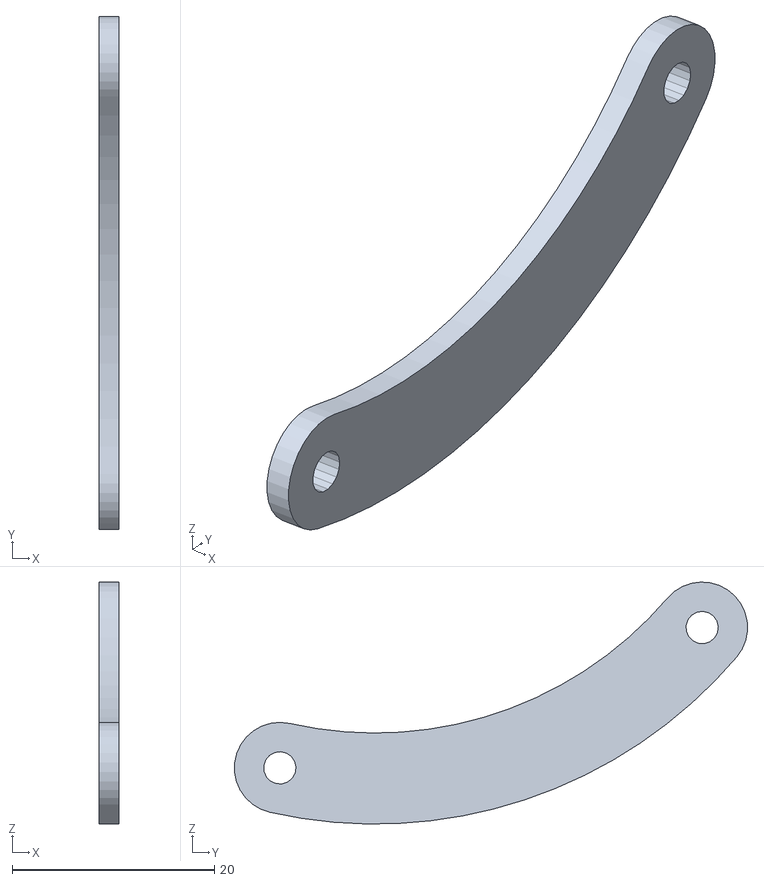
[picture p48: CAD file, 2026-10-22]
cad/stl/mano_final_V3_Diag_medio_30.stl
2.00 x 50.7 x 23.9
