lumunoz12/preprosthetic-robotic-hand/matlab/simulink/cad/tapa_pulgar_ipt_d83de9.STEP

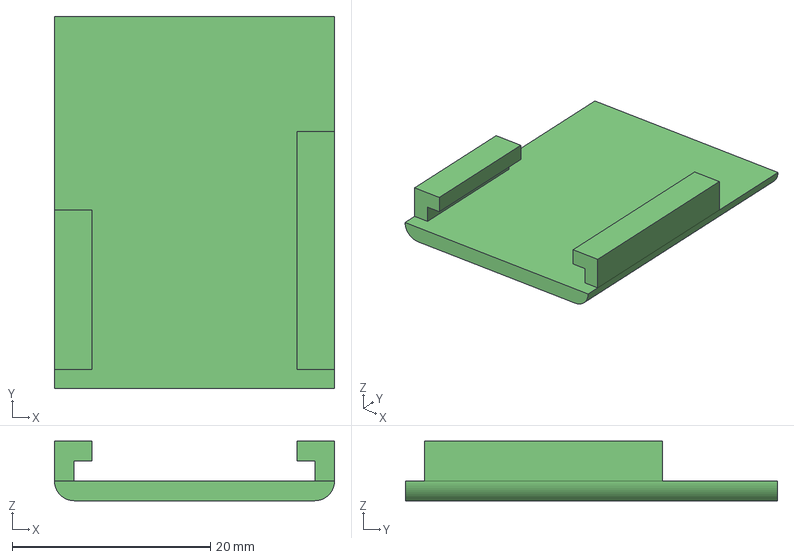
[picture p49: CAD file, 2026-10-24]
matlab/simulink/cad/tapa_pulgar_ipt_d83de9.STEP
28.3 x 37.5 x 6.00 mm
