lumunoz12/preprosthetic-robotic-hand/matlab/simulink/cad/Esl2_ipt_5f6dfdfa.STEP

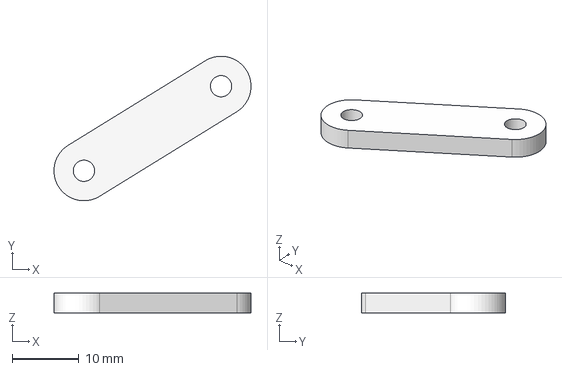
[picture p50: CAD file, 2026-10-24]
matlab/simulink/cad/Esl2_ipt_5f6dfdfa.STEP
29.6 x 21.7 x 3.00 mm
