lumunoz12/preprosthetic-robotic-hand/matlab/simulink/cad/Prox_pulgar_ipt_552c8f7.STEP

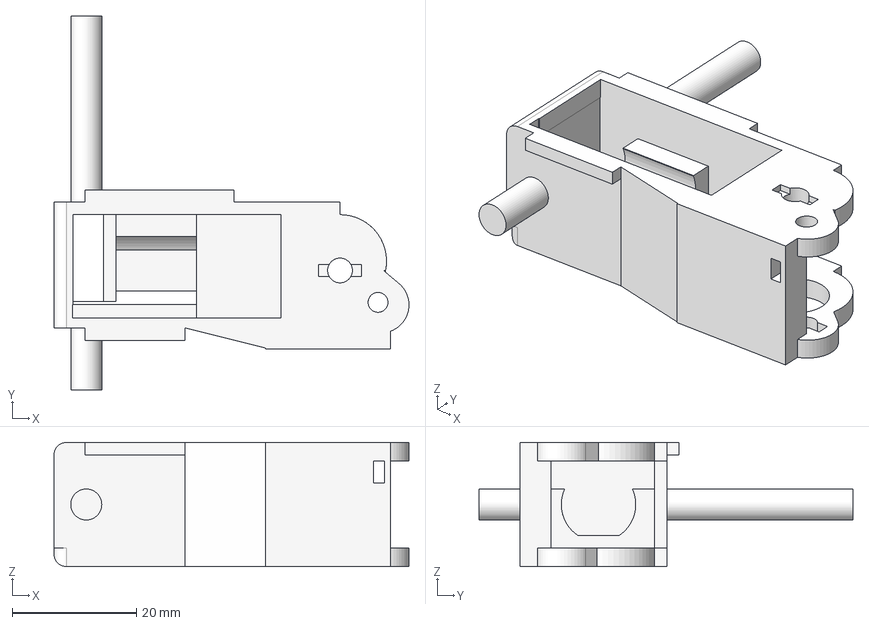
[picture p52: CAD file, 2026-10-24]
matlab/simulink/cad/Prox_pulgar_ipt_552c8f7.STEP
57.2 x 60.2 x 20.0 mm
