lumunoz12/preprosthetic-robotic-hand/matlab/simulink/cad/Esl6_ipt_438fbb8.STEP

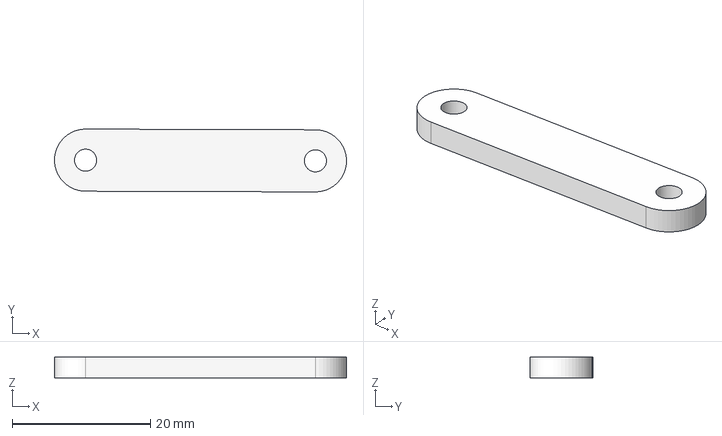
[picture p53: CAD file, 2026-10-24]
matlab/simulink/cad/Esl6_ipt_438fbb8.STEP
42.3 x 9.10 x 3.00 mm
