lumunoz12/preprosthetic-robotic-hand/matlab/simulink/cad/Tierra_medio_ipt_749dbfaf.STEP

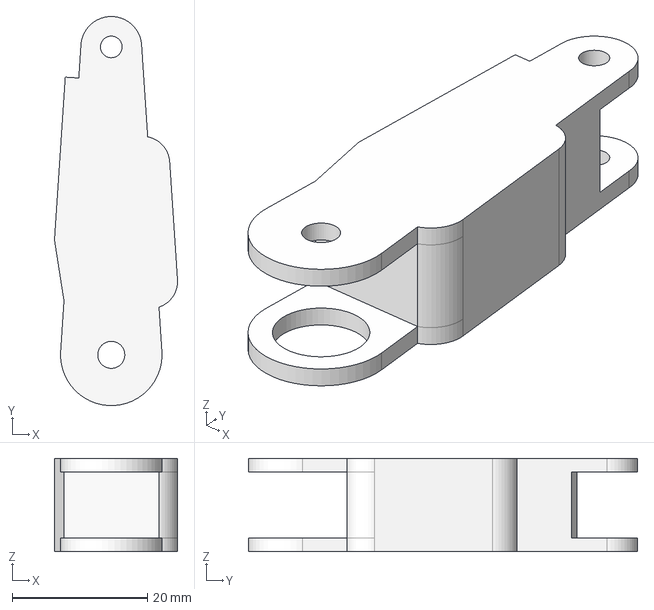
[picture p54: CAD file, 2026-10-24]
matlab/simulink/cad/Tierra_medio_ipt_749dbfaf.STEP
18.2 x 57.5 x 13.8 mm
