lumunoz12/preprosthetic-robotic-hand/cad/stl/mano_final_V3_Meta_medio_23.stl

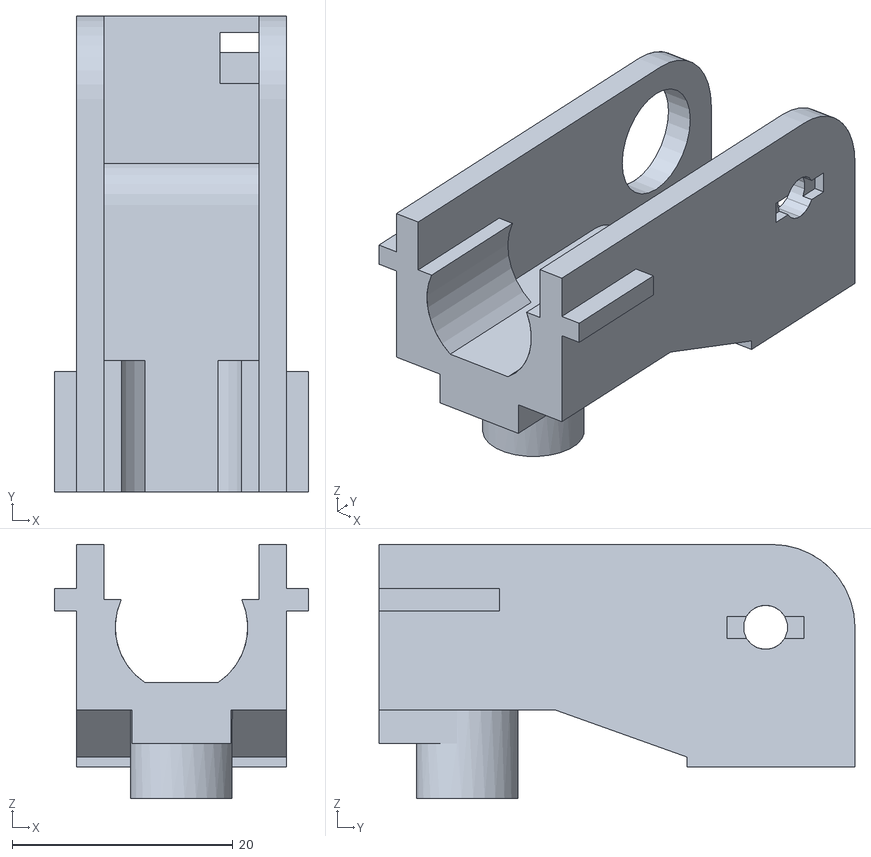
[picture p55: CAD file, 2026-10-22]
cad/stl/mano_final_V3_Meta_medio_23.stl
23.0 x 43.1 x 23.0
