lumunoz12/preprosthetic-robotic-hand/matlab/simulink/cad/Tierra_pulgar_ipt_749dbfaf.STEP

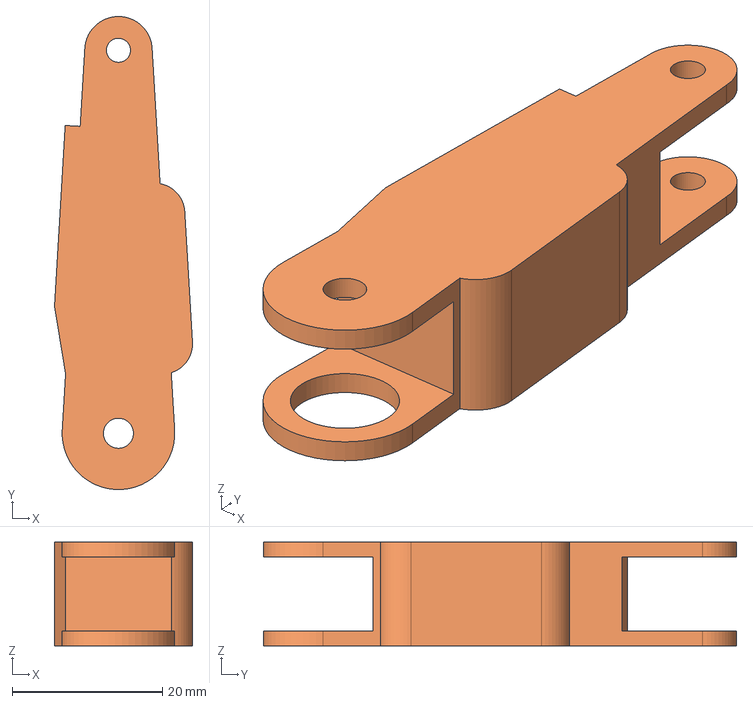
[picture p56: CAD file, 2026-10-24]
matlab/simulink/cad/Tierra_pulgar_ipt_749dbfaf.STEP
18.4 x 63.0 x 13.8 mm
