lumunoz12/preprosthetic-robotic-hand/matlab/simulink/cad/Tierra_menique_ipt_749dbfaf.STEP

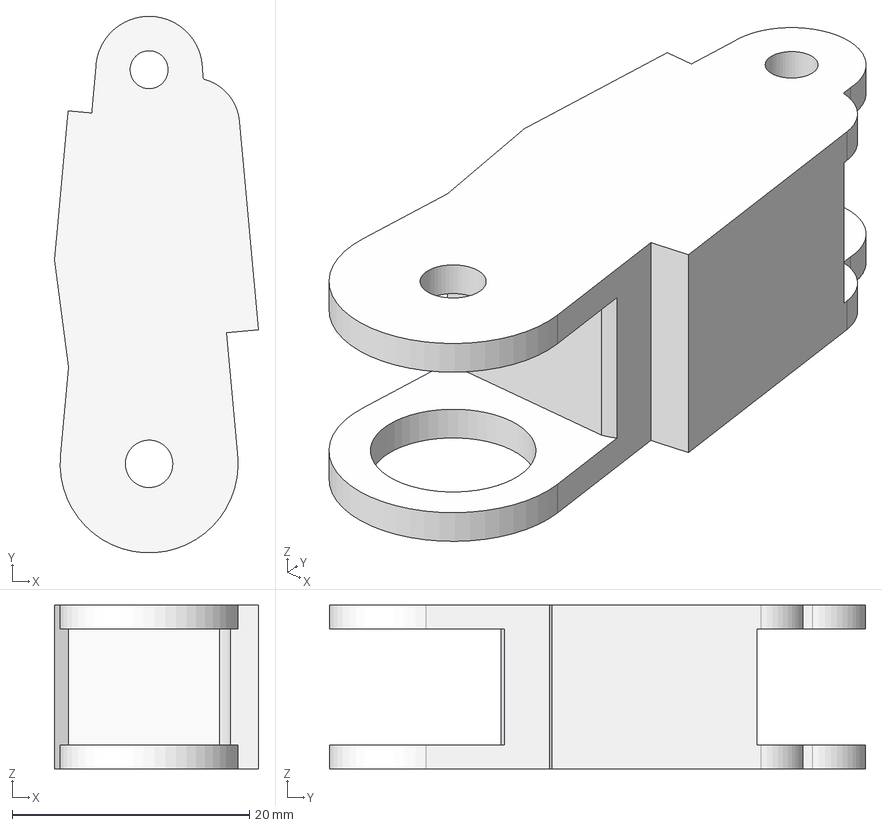
[picture p57: CAD file, 2026-10-24]
matlab/simulink/cad/Tierra_menique_ipt_749dbfaf.STEP
17.2 x 45.2 x 13.8 mm
