lumunoz12/preprosthetic-robotic-hand/cad/stl/mano_final_V3_segunda_anular2_32.stl

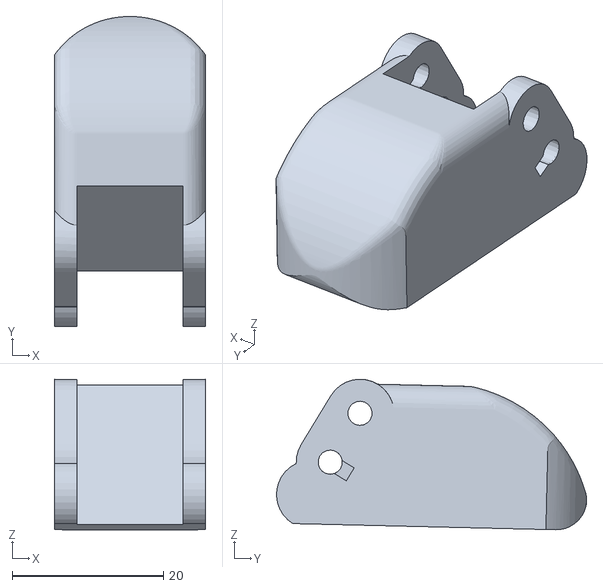
[picture p58: CAD file, 2026-10-22]
cad/stl/mano_final_V3_segunda_anular2_32.stl
20.0 x 41.0 x 19.9
