lumunoz12/preprosthetic-robotic-hand/cad/stl/mano_final_V3_distal_medio_27.stl

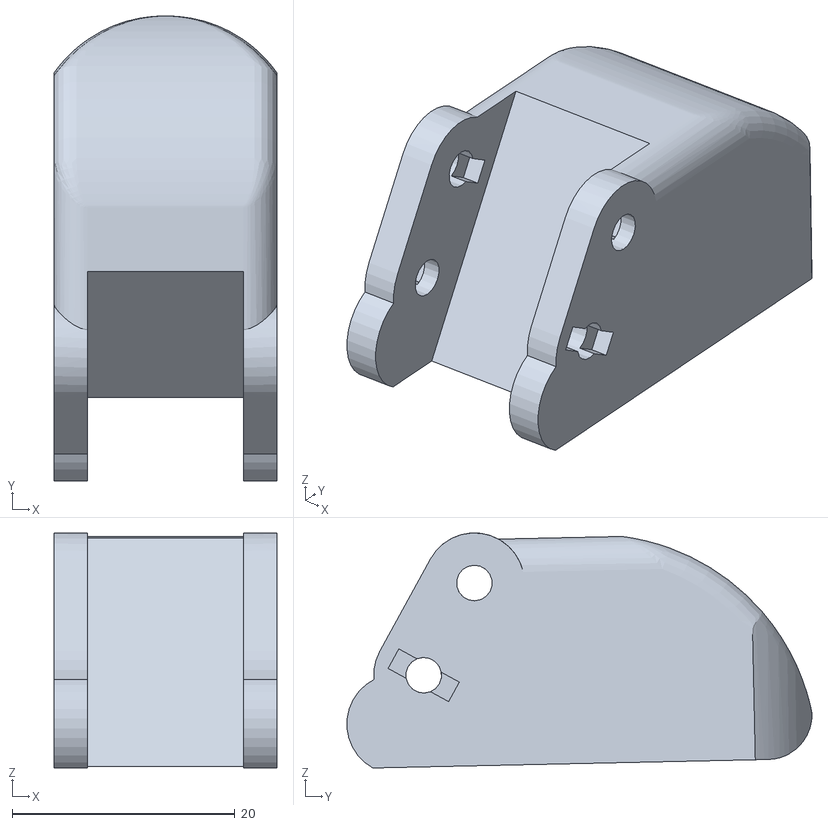
[picture p59: CAD file, 2026-10-22]
cad/stl/mano_final_V3_distal_medio_27.stl
20.0 x 41.8 x 21.1
