lumunoz12/preprosthetic-robotic-hand/cad/stl/mano_final_V3_distal_indice_21.stl

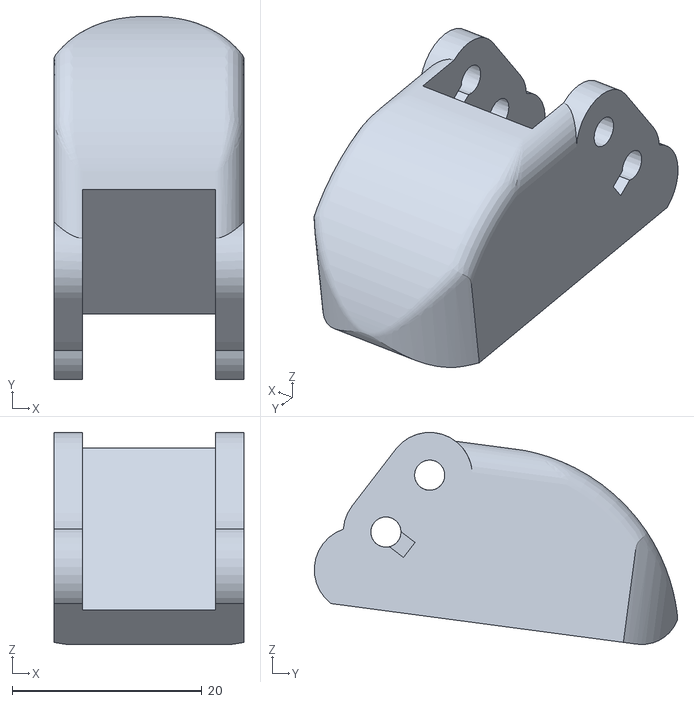
[picture p60: CAD file, 2026-10-22]
cad/stl/mano_final_V3_distal_indice_21.stl
20.0 x 38.3 x 22.3
