lumunoz12/preprosthetic-robotic-hand/cad/stl/mano_final_V3_distal_pulgar_5.stl

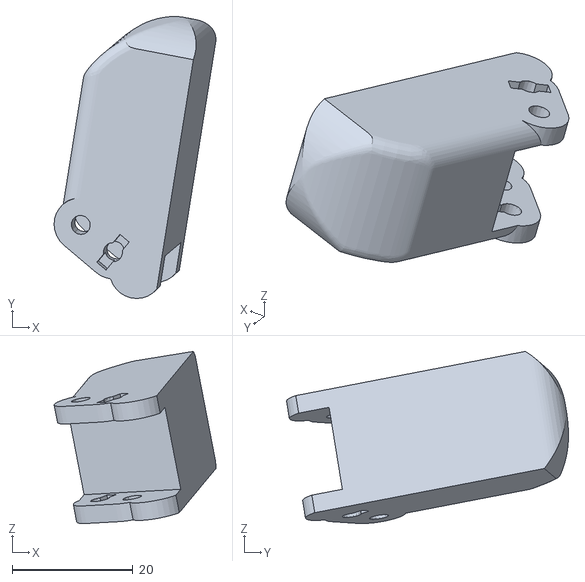
[picture p61: CAD file, 2026-10-22]
cad/stl/mano_final_V3_distal_pulgar_5.stl
26.8 x 46.7 x 28.5
