lumunoz12/preprosthetic-robotic-hand/cad/stl/mano_final_V3_Palma_1.stl

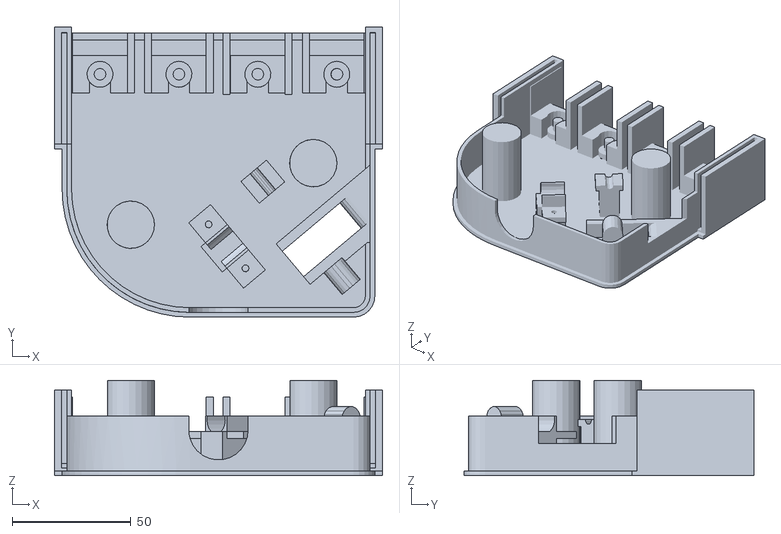
[picture p62: CAD file, 2026-10-22]
cad/stl/mano_final_V3_Palma_1.stl
138.4 x 122.5 x 40.1
