lumunoz12/preprosthetic-robotic-hand/cad/stl/mano_final_V3_Diag_Anular_34.stl

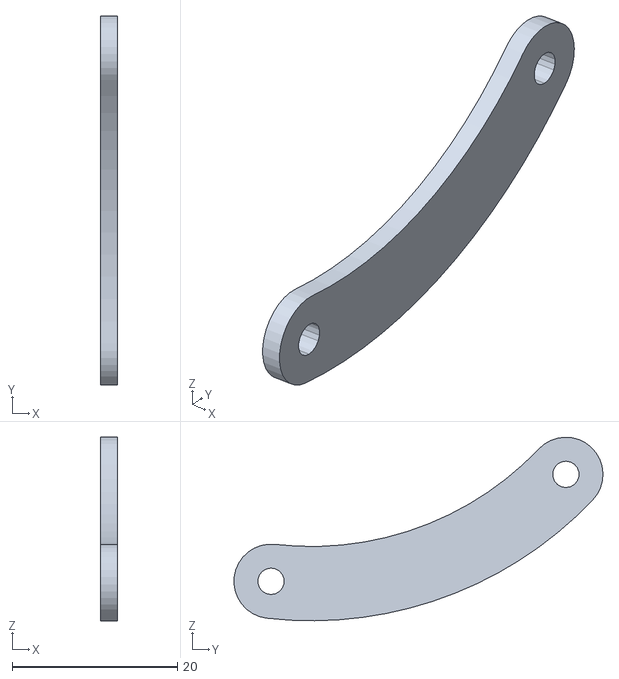
[picture p63: CAD file, 2026-10-22]
cad/stl/mano_final_V3_Diag_Anular_34.stl
2.00 x 44.7 x 22.2
