lumunoz12/preprosthetic-robotic-hand/cad/stl/mano_final_V3_tapa_pulgar_PIP_40.stl

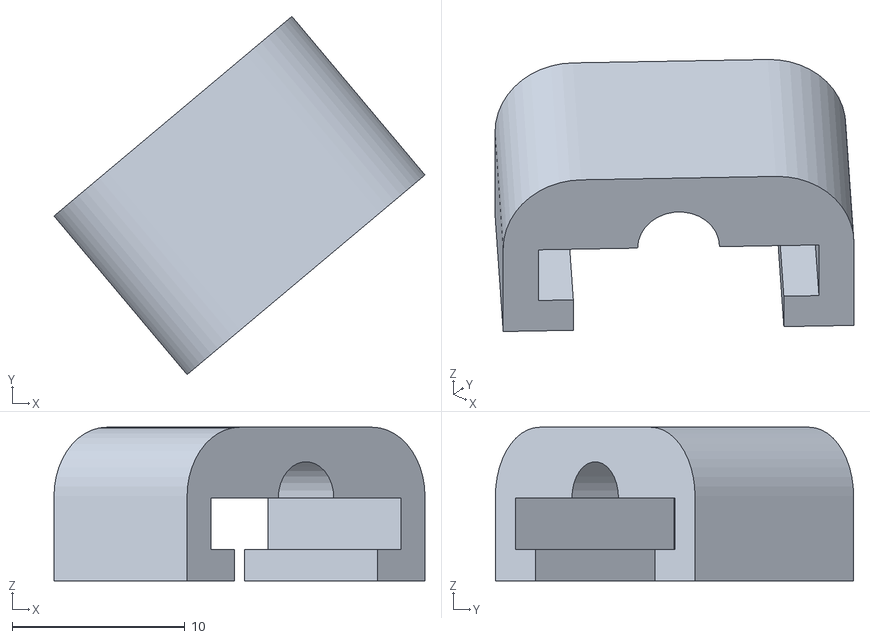
[picture p64: CAD file, 2026-10-22]
cad/stl/mano_final_V3_tapa_pulgar_PIP_40.stl
21.5 x 20.8 x 8.90
