lumunoz12/preprosthetic-robotic-hand/cad/stl/mano_final_V3_transmision_motor_78.stl

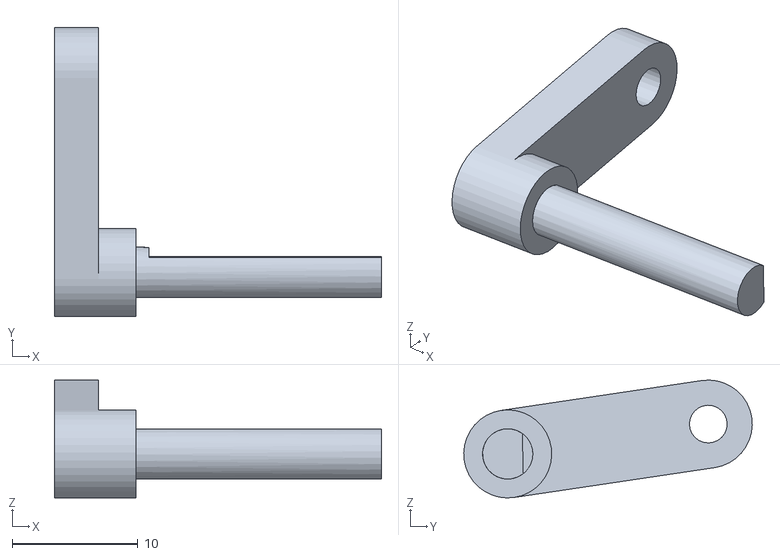
[picture p65: CAD file, 2026-10-22]
cad/stl/mano_final_V3_transmision_motor_78.stl
26.0 x 22.9 x 9.37
