lumunoz12/preprosthetic-robotic-hand/cad/stl/mano_final_V3_transmision_motor_72.stl

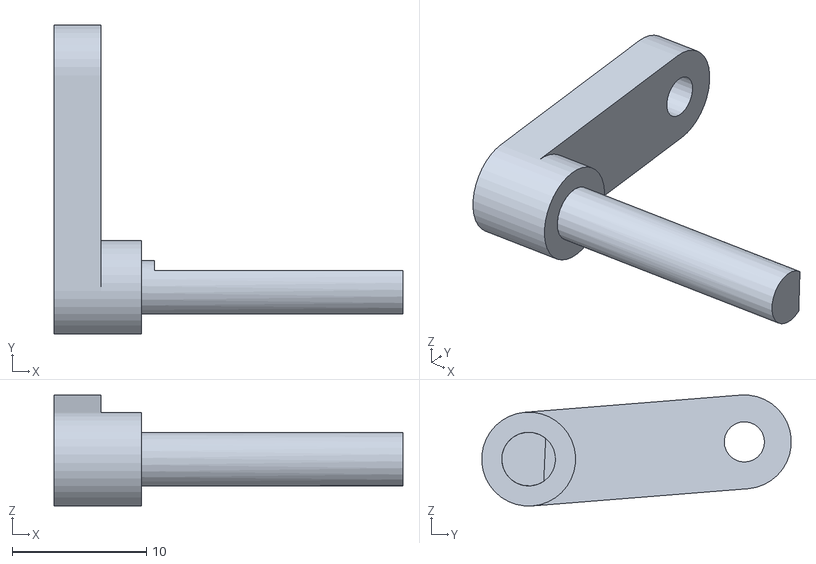
[picture p66: CAD file, 2026-10-22]
cad/stl/mano_final_V3_transmision_motor_72.stl
26.0 x 23.1 x 8.26
