lumunoz12/preprosthetic-robotic-hand/cad/stl/mano_final_V3_tapa_pulgar_7.stl

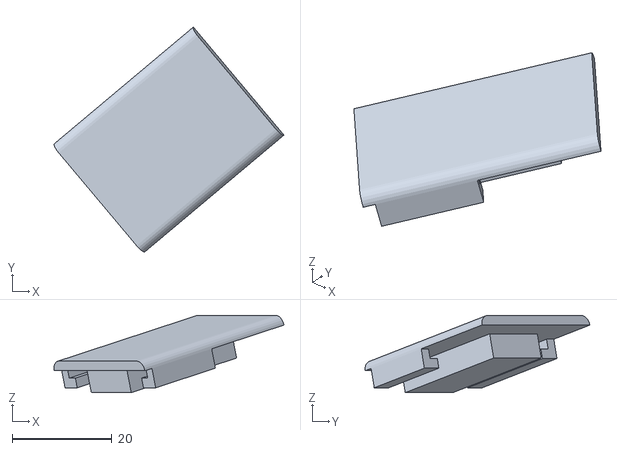
[picture p67: CAD file, 2026-10-22]
cad/stl/mano_final_V3_tapa_pulgar_7.stl
46.1 x 45.0 x 15.5
