lumunoz12/preprosthetic-robotic-hand/cad/stl/mano_final_V3_Prox_pulgar_2.stl

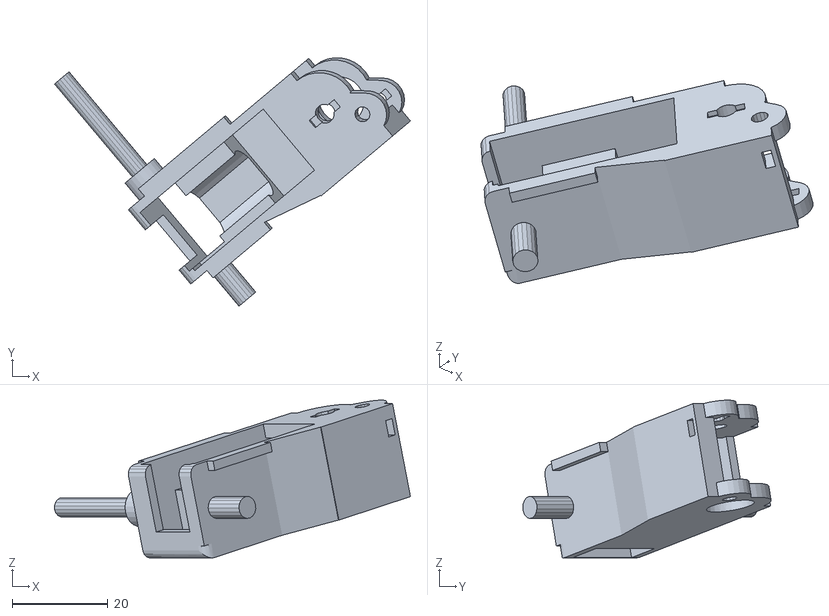
[picture p68: CAD file, 2026-10-22]
cad/stl/mano_final_V3_Prox_pulgar_2.stl
74.3 x 51.8 x 32.9
