lumunoz12/preprosthetic-robotic-hand/(list of files, cad)

Other CAD files:
cad/native/Templates/English/ANSI (in).dwg
cad/native/Templates/Metric/GB.dwg
cad/native/Templates/Metric/ANSI (mm).dwg
cad/native/Templates/Metric/DIN.dwg
cad/native/Templates/Metric/GOST.dwg
cad/native/Templates/Metric/JIS.dwg
cad/native/Templates/Metric/BSI.dwg
cad/stl/mano_final_V3_Tapa_meta_indice_28.stl
matlab/simulink/cad/Diag_Indice_ipt_fb0efa85.STEP
cad/stl/mano_final_V3_Prox_Indice_17.stl
matlab/simulink/cad/Tapa_prox_indice_ipt_ad682b4a.STEP
cad/stl/mano_final_V3_Prox_medio_24.stl
cad/stl/mano_final_V3_Diag_menique_11.stl
cad/stl/mano_final_V3_Diag_pulgar_6.stl
cad/stl/mano_final_V3_Tapa_prox_medio_18.stl
cad/stl/mano_final_V3_Tapa_meta_indice_14.stl
cad/stl/mano_final_V3_Tapa_prox_medio_62.stl
cad/stl/mano_final_V3_Tierra_Indice_37.stl
cad/stl/mano_final_V3_Tapa_meta_indice_16.stl
cad/stl/mano_final_V3_Diag_Indice_20.stl
cad/stl/mano_final_V3_Diag_Anular_33.stl
cad/stl/mano_final_V3_Diag_medio_26.stl
cad/stl/mano_final_V3_Meta_indice_31.stl
cad/native/Design Data/Cable & Harness/es-ES/harness.iam
cad/native/Design Data/Tube & Pipe/es-ES/piping runs.iam
cad/native/Templates/English/Mold Design (in).iam
cad/native/Templates/English/Standard (in).ipn
cad/native/Templates/Metric/DIN.idw
cad/native/Templates/Metric/Mold Design (DIN).iam
cad/native/Templates/Metric/Mold Design (mm).iam
cad/native/Templates/Metric/Sheet Metal (DIN).ipt
cad/native/Templates/Metric/Sheet Metal (mm).ipt
cad/native/Templates/Metric/Standard (DIN).iam
cad/native/Templates/Metric/Standard (DIN).ipn
cad/native/Templates/Metric/Standard (DIN).ipt
cad/native/Templates/Metric/Standard (mm).ipt
cad/native/Templates/Metric/Weldment (DIN).iam
cad/native/Templates/OldTemplates/Standard.iam
cad/native/Templates/OldTemplates/Standard.idw
cad/native/Templates/OldTemplates/Standard.ipn
cad/native/Templates/OldTemplates/Weldment.iam
cad/native/Templates/OldTemplates/standard.dwg
cad/native/Templates/Sheet Metal.ipt
cad/native/Templates/Standard.iam
cad/native/Templates/Standard.ipt
cad/native/Workgroups/NotInProject/12T.ipt
cad/native/Workgroups/NotInProject/24T.ipt
cad/native/Workgroups/NotInProject/Cubre_palma.ipt
cad/native/Workgroups/NotInProject/Diag_Anular.ipt
cad/native/Workgroups/NotInProject/Meta_indice.ipt
cad/native/Workgroups/NotInProject/N20 Mini Micro Metall Gear Motor DC 3-6-12V v1.ipt
cad/native/Workgroups/NotInProject/Palma.ipt
cad/native/Workgroups/NotInProject/Tapa_meta_indice.ipt
cad/native/Workgroups/NotInProject/anular_VF/Diag_Indice.ipt
cad/native/Workgroups/NotInProject/anular_VF/Meta_anular.ipt
cad/native/Workgroups/NotInProject/anular_VF/Prox_Indice.ipt
cad/native/Workgroups/NotInProject/anular_VF/Tierra_Indice.ipt
cad/native/Workgroups/NotInProject/anular_VF/distal_indice.ipt
cad/native/Workgroups/NotInProject/engranes.iam
cad/native/Workgroups/NotInProject/indice_VF/Prox_anularVF2.ipt
cad/native/Workgroups/NotInProject/indice_VF/transmision_motor.ipt
cad/native/Workgroups/NotInProject/indice_VF/transmision_motor_anular.ipt
cad/native/Workgroups/NotInProject/indice_VF/transmision_motor_medio.ipt
cad/native/Workgroups/NotInProject/indice_VF/tuerca.ipt
cad/native/Workgroups/NotInProject/mano_VF.iam
cad/native/Workgroups/NotInProject/medio_VF/Diag_medio.ipt
cad/native/Workgroups/NotInProject/medio_VF/Meta_medio.ipt
cad/native/Workgroups/NotInProject/medio_VF/Prox_medio.ipt
cad/native/Workgroups/NotInProject/medio_VF/Tapa_prox_medio.ipt
cad/native/Workgroups/NotInProject/medio_VF/Tierra_medio.ipt
cad/native/Workgroups/NotInProject/medio_VF/distal_medio.ipt
cad/native/Workgroups/NotInProject/menique_VF/Diag_menique.ipt
cad/native/Workgroups/NotInProject/menique_VF/Meta_menique.ipt
cad/native/Workgroups/NotInProject/menique_VF/Prox_menique.ipt
cad/native/Workgroups/NotInProject/menique_VF/Tierra_menique.ipt
cad/native/Workgroups/NotInProject/menique_VF/distal_menique.ipt
cad/native/Workgroups/NotInProject/pulgar_VF/Diag_pulgar.ipt
cad/native/Workgroups/NotInProject/pulgar_VF/Prox_pulgar.ipt
cad/native/Workgroups/NotInProject/pulgar_VF/Tierra_pulgar.ipt
cad/native/Workgroups/NotInProject/pulgar_VF/distal_pulgar.ipt
cad/native/Workgroups/NotInProject/pulgar_VF/tapa_pulgar.ipt
cad/native/Workgroups/NotInProject/sabado/tapa_pulgar_PIP.ipt
cad/native/Workgroups/NotInProject/segunda_anular2.ipt
