lumunoz12/preprosthetic-robotic-hand/firmware/final.ioc

Mcu.UserName=STM32F767ZITx
PA0/WKUP.Signal=S_TIM5_CH1
PA1.Signal=S_TIM5_CH2
PA5.Signal=S_TIM2_CH1_ETR
PB10.Signal=GPXTI10
PB11.Signal=GPXTI11
PB14.Signal=S_TIM12_CH1
PB15.Signal=S_TIM12_CH2
PB3.Signal=S_TIM2_CH2
PB4.Signal=S_TIM3_CH1
PB5.Signal=S_TIM3_CH2
PB6.Signal=GPXTI6
PB8.Signal=S_TIM10_CH1
PB9.Signal=S_TIM11_CH1
PC0.Signal=ADCx_IN10
PC10.Signal=GPIO_Output
PC11.Signal=GPIO_Output
PC12.Signal=GPIO_Output
PC3.Signal=ADCx_IN13
PC6.Signal=S_TIM8_CH1
PC7.Signal=S_TIM8_CH2
PC8.Signal=GPIO_Output
PC9.Signal=GPIO_Output
PD12.Signal=S_TIM4_CH1
PD13.Signal=S_TIM4_CH2
PD2.Signal=GPIO_Output
PD4.Signal=GPIO_Output
PD5.Signal=GPIO_Output
PD6.Signal=GPIO_Output
PD7.Signal=GPIO_Output
PD8.Signal=USART3_TX
PD9.Signal=USART3_RX
PE0.Signal=GPXTI0
PE11.Signal=S_TIM1_CH2
PE12.Signal=GPXTI12
PE14.Signal=GPXTI14
PE15.Signal=GPXTI15
PE2.Signal=GPIO_Output
PE4.Signal=GPIO_Output
PE5.Signal=S_TIM9_CH1
PE6.Signal=S_TIM9_CH2
PE7.Signal=GPIO_Output
PE8.Signal=GPIO_Output
PE9.Signal=S_TIM1_CH1
PF11.Signal=GPIO_Output
PF13.Signal=GPXTI13
PF15.Signal=GPIO_Output
PF3.Signal=GPIO_Output
PF4.Signal=GPXTI4
PF5.Signal=GPIO_Output
PF7.Signal=GPIO_Output
PF8.Signal=S_TIM13_CH1
PF9.Signal=S_TIM14_CH1
PG2.Signal=GPIO_Output
PG3.Signal=GPIO_Output
PG8.Signal=GPXTI8
