lumunoz12/preprosthetic-robotic-hand/(commit log)

2026-10-22 Add native Autodesk Inventor CAD project
2026-10-22 Add photo hand and data Motor
2026-10-22 Enhance README with additional firmware details
    Updated README to include UART command details, grasp sequences, and control implementation specifics.
2026-10-22 Delate Scale finger and torque
2026-10-23 Add link to budget spreadsheet in README
    Updated the Bill of Materials section to include a link to the budget spreadsheet.
